wyolum/uControl_v3/KiCAD/BoM_uControl_v3.pdf

uControl_v3 | | | | Bill of Materials | | | www.wyolum.com
Reference | Quantity | Description | value | footprint | Manufacturer | Manufacturer PN | Distributor PN
BT1 | 1 | BATT_HOLDER | CR2032 | Keystone Electronics 3003 | 3003K-ND
BT2 | 1 | BATTERY LITHIUM COIN 3V 20MM BATT_COIN | -- | Panasonic - BSG | CR2032 | P189-ND
25 | CAP CER 0.1UF 100V 10% X7R 0805 100nF, 100V | 0805 (2012 Metric) | CL21B104KCC5PNC | 1276-2447-1-ND
C19,C33 | 2 | CAP CER 22UF 25V 10% X7R 1210 | 22uF X7R | 1210 (3225 Metric) | CL32B226KAJNNNE | 1276-3392-2-ND
C2,C3 | 2 | CAP CER 22PF 50V 5% NP0 0603 | 22pF, 50V | 0603 (1608 Metric) | CL10C220JB8NNNC | 1276-1023-1-ND
C21,C35 | 2 | CAP CER 3300PF 50V 10% X7R 0805 3.3nF, 50V | 0805 (2012 Metric) | CL21B332KBANNNC | 1276-1260-1-ND
C22,C26,C27,C36,C37,C42 | 6 | CAP ALUM 100UF 35V 20% SMD | 100uF, 35V | | UWT1V101MCL1GS | 493-2203-1-ND
C30,C38 | 2 | CAP CER 10UF 35V 10% X7R 1206 | 10uF, 35V | 1206 (3216 Metric) | CL31B106KLHNNNE | 1276-3103-1-ND
D1,D3,D4,D9 | 4 | DIODE GEN PURPOSE 200V 1A SMA S1D-13-F | DO-214AC, SMA | S1D-13-F | S1D-FDICT-ND
D5 | 1 | | LED 5V0 | 2-SMD, J-Lead | LG M67K-H1J2-24-Z | 475-2730-1-ND
D6 | 1 | | LED 3V3 | 2-SMD, J-Lead | LG M67K-H1J2-24-Z | 475-2730-1-ND
D7 | 1 | | LED BLINK | 2-SMD, J-Lead | LG M67K-H1J2-24-Z | 475-2730-1-ND
D8 | 1 | | LED 12V | 2-SMD, J-Lead | LG M67K-H1J2-24-Z | 475-2730-1-ND
J1 | 1 | | 5V_EXT | | PRPC002SFAN-RC | S1211EC-02-ND
J2 | 1 | | 3V3_EXT | | PRPC002SFAN-RC | S1211EC-02-ND
J3 | 1 | CONN HEADER 4POS .100 STR TIN | FCI | 67997-404HLF | 609-3242-ND

Distributor
(Link)
HOLDER BATTERY COIN 20MM DIA THM

Digikey (http://www.digikey.com/scripts/DkSearch/dksus.dll?x=0&y=0&lang=en&KeyWords=3003K-ND&cur=USD)

Digikey (http://www.digikey.com/product-detail/en/CR2032/P189-ND/31939?cur=USD)

C1,C4,C5,C7,C8,C9,C10,C1
1,C12,C13,C14,C17,C18,C2
0,C23,C28,C29,C31,C32,C3
4,C39,C40,C41,C43,C44

Samsung Electro-Mechanics America,
Inc

Digikey (http://www.digikey.com/product-detail/en/CL21B104KCC5PNC/1276-2447-1-ND/3890533)

Samsung Electro-Mechanics America,
Inc

Digikey (http://www.digikey.com/product-detail/en/CL32B226KAJNNNE/1276-3392-1-ND/3891478)

Samsung Electro-Mechanics America,
Inc

Digikey (http://www.digikey.com/product-detail/en/CL10C220JB8NNNC/1276-1023-1-ND/3889109)

Samsung Electro-Mechanics America,
Inc

Digikey (http://www.digikey.com/product-detail/en/CL21B332KBANNNC/1276-1260-1-ND/3889346)

Radial, Can – SMD, 0.260" L x 0.260" W (6.60mm x
6.60mm)
Nichicon | Digikey (http://www.digikey.com/product-detail/en/UWT1V101MCL1GS/493-2203-1-ND/590178)

Samsung Electro-Mechanics America,
Inc

Digikey (http://www.digikey.com/product-detail/en/CL31B106KLHNNNE/1276-3103-1-ND/3891189)

Diodes Inc | Digikey (http://www.digikey.com/product-detail/en/S1D-13-F/S1D-FDICT-ND/815934)

LED MINI TOPLED GREEN 570NM SMD

OSRAM Opto
Semiconductors Inc

Digikey (http://www.digikey.com/product-detail/en/LG%20M67K-H1J2-24-Z/475-2730-1-ND/1938897)

LED MINI TOPLED GREEN 570NM SMD

OSRAM Opto
Semiconductors Inc

Digikey (http://www.digikey.com/product-detail/en/LG%20M67K-H1J2-24-Z/475-2730-1-ND/1938897)

LED MINI TOPLED GREEN 570NM SMD

OSRAM Opto
Semiconductors Inc

Digikey (http://www.digikey.com/product-detail/en/LG%20M67K-H1J2-24-Z/475-2730-1-ND/1938897)

LED MINI TOPLED GREEN 570NM SMD

OSRAM Opto
Semiconductors Inc

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

CONN HEADER .100" SNGL STR 2POS

Through hole, 0.100"
(2.54mm)

Sullins Connector
Solutions

Digikey (http://www.digikey.com/product-detail/en/PRPC002SFAN-RC/S1211EC-02-ND/2775372)

CONN HEADER .100" SNGL STR 2POS

Through hole, 0.100"
(2.54mm)

Sullins Connector
Solutions

Digikey (http://www.digikey.com/product-detail/en/PRPC002SFAN-RC/S1211EC-02-ND/2775372)

addr | Through hole, 0.100"
(2.54mm)

Digikey (http://www.digikey.com/product-detail/en/67997-404HLF/609-3242-ND/1878458)

Reference | Quantity | Description | value | footprint | Manufacturer | Manufacturer PN | Distributor | Distributor PN
| | | | | | | (Link)
L1,L2 | 2 | | 2.2uH | | | XFL4020-222MEB | | 994-XFL4020-222MEB
P11 | 1 | | | | | PREC003SAAN-RC | | S1012EC-03-ND
P13 | 1 | | PWR_IN | | | PRPC002SFAN-RC | | S1211EC-02-ND
P14 | 1 | | X_VALVE | 8mm Solenoid Valve | | X-1-05-S-F | | X-1-05-S-F
P15 | 1 | | | Surface Mount, Right Angle | | 5023520400 | | WM7171CT-ND
P16 | 1 | | FLOWMETER | custom | | SFM3000 | | SFM3000
P17 | 1 | Pump_P54E01R_02 | PUMP | custom | | P54E01R | | P54E01R
P18 | 1 | Pump Cable | Pump Cable | --
P21,P22 | 2 | | CONN_23X2 | | | PREC028DFAN-RC | | S2212EC-28-ND
P24 | 1 | | PWR_IN | | | PJ-002B | | CP-002B-ND
P31 | 1 | | | --
P34 | 1 | | | | | PREC003SAAN-RC | | S1012EC-03-ND
P38 | 1 | | X_Valve2 | 8mm Solenoid Valve | | X-1-05-S-F | | X-1-05-S-F
P4 | 1 | | Header_ISP | | | PREC003DAAN-RC | | S2012EC-03-ND
P5 | 1 | | Header_FTDI | | | PREC006SAAN-RC | | S1012EC-06-ND
P7 | 1 | | GAGE_PR | HCEM500GUH9P3 | | HCEM500GUH9P3 | | HCEM500GUH9P3
P8 | 1 | Amplified pressure sensor | ABSO_PR | HDIB002AUY8H5 | | HDIB002AUY8H5 | | HDIB002AUY8H5
P9,P10 | 2 | | C3SB | | | PREC004SAAN-RC | | S1012EC-04-ND
Q1,Q2,Q3,Q4 | 4 | TRANS NPN 45V 1A 2W SOT223 | BCP5416TA | SOT-223 | | BCP5416TA | | BCP5416TACT-ND
Q5 | 1 | MOSFET NCH 60V 310MA SOT323 2N7002KW | SOT-323 | 2N7002KW | 2N7002KWCT-ND
| 10 | RES 10K OHM 1/8W 5% 0805 | 10k | 0805 (2012 Metric) | | RMCF0805JT10K0 | | RMCF0805JT10K0CT-ND
R16,R17,R18,R23 | 4 | RES 4.75K OHM 1/8W 1% 0805 | 4k75 | 0805 (2012 Metric) | | RMCF0805FT4K75 | | RMCF0805FT4K75CT-ND
R19,R20 | 2 | RES 1.5K OHM 1/8W 5% 0805 | 1k5 | 0805 (2012 Metric) | | RMCF0805JT1K50 | | RMCF0805JT1K50CT-ND
R24,R25 | 2 | RES 220 OHM 1/8W 5% 0805 | 220 | 0805 (2012 Metric) | | RMCF0805JT220R | | RMCF0805JT220RCT-ND
Power Inductor 2.2 uH 20 % 8 A | 4.3 mm W x 4.3 mm L x 2.1
mm H
| Coilcraft | Mouser (http://in.mouser.com/ProductDetail/Coilcraft/XFL4020-222MEB/?qs=VJjuEbE9QBO2bwonVBK1EA==)

CONN HEADER .100" SNGL STR
3POS
VSel_Vlv | Through hole, 0.100"
(2.54mm)
| Sullins Connector Solutions | Digikey (http://www.digikey.com/product-detail/en/PREC003SAAN-RC/S1012EC-03-ND/2774851)

CONN HEADER .100" SNGL STR 2POS

Through hole, 0.100"
(2.54mm)
| Sullins Connector Solutions | Digikey (http://www.digikey.com/product-detail/en/PRPC002SFAN-RC/S1211EC-02-ND/2775372)

Miniature Pneumatic Solenoid Valve

| Parker Hannifin | Parker Hannifin (http://ph.parker.com/webapp/wcs/stores/servlet/Product2_10151_12051_12163_-1_14107_14097___ProductDisplay)

CONN HEADER 4POS 2MM R/A
SMD
Flow_Conn | Molex Inc | Digikey (http://www.digikey.com/product-detail/en/5023520400/WM7171CT-ND/3045198)

Low-Pressure-Drop Flow Meter SFM3000

| Sensiron | Sensiron (http://www.sensirion.com/en/products/mass-flow-meters-for-gases/mass-flow-meter-sfm3000/)
| Oken Seiko | Oken Seiko (http://www.okenseiko.com/ja/prod/rollingP/air/P54E01R.pdf)

CONN HEADER .100" DUAL STR 56POS

Through hole, 0.100"
(2.54mm)
| Sullins Connector Solutions | DigiKey (http://www.digikey.com/product-detail/en/PREC028DFAN-RC/S2212EC-28-ND/2774986)

CONN POWER JACK MALE 2.5MM CLSD

Through Hole, Right Angle, 2.5mm ID, 5.5mm OD

| CUI Inc | DigiKey (http://www.digikey.com/product-search/en?vendor=0&keywords=CP-002B-ND)

Flowmeter Cable
CONN HEADER .100" SNGL STR 3POS
VSel_Vlv2 | Through hole, 0.100"
(2.54mm)
| Sullins Connector Solutions | Digikey (http://www.digikey.com/product-detail/en/PREC003SAAN-RC/S1012EC-03-ND/2774851)

Miniature Pneumatic Solenoid Valve

| Parker Hannifin | Parker Hannifin (http://ph.parker.com/webapp/wcs/stores/servlet/Product2_10151_12051_12163_-1_14107_14097___ProductDisplay)

CONN HEADER .100" DUAL STR 6POS

Through hole, 0.100"
(2.54mm)
| Sullins Connector Solutions | Digikey (http://www.digikey.com/product-detail/en/PREC003DAAN-RC/S2012EC-03-ND/2774891)

CONN HEADER .100" SNGL STR 6POS

Through hole, 0.100"
(2.54mm)
| Sullins Connector Solutions | Digikey (http://www.digikey.com/product-search/en?vendor=0&keywords=PREC006SAAN-RC)

Miniature amplified pressure sensor

| SensorTechnics | SensorTechnics (http://www.sensortechnics.com/en/products/pressure-sensors-and-transmitters/amplified-pressure-sensors/hce/)
| SensorTechnics | SensorTechnics (http://www.sensortechnics.com/en/products/pressure-sensors-and-transmitters/amplified-pressure-sensors/hdi/)
CONN HEADER .100" SNGL STR 4POS

Through hole, 0.100"
(2.54mm)
| Sullins Connector Solutions | Digikey (http://www.digikey.com/product-search/en?vendor=0&keywords=PREC004SAAN-RC)
| Diodes Inc | Digikey (http://www.digikey.com/product-detail/en/BCP5416TA/BCP5416TACT-ND/2712056)
| Fairchild Semiconductor | Digikey (http://www.digikey.com/product-detail/en/2N7002KW/2N7002KWCT-ND/3907885)

R1,R2,R3,R4,R11,R15,R21,
R22,R26,R27
| Stackpole Electronics Inc | DigiKey (http://www.digikey.com/product-detail/en/RMCF0805JT10K0/RMCF0805JT10K0CT-ND/1942577)
| Stackpole Electronics Inc | DigiKey (http://www.digikey.com/product-detail/en/RMCF0805FT4K75/RMCF0805FT4K75CT-ND/1942413)
| Stackpole Electronics Inc | Digikey (http://www.digikey.com/product-detail/en/RMCF0805JT1K50/RMCF0805JT1K50CT-ND/1942560)
| Stackpole Electronics Inc | Digikey (http://www.digikey.com/product-detail/en/RMCF0805JT220R/RMCF0805JT220RCT-ND/1942544)

Reference | Quantity | Description | value | footprint | Manufacturer | Manufacturer PN | Distributor | Distributor PN
| | | | | | | (Link)
R5,R12 | 2 | RES 4.7K OHM 1/8W 5% 0805 | 4k7 | 0805 (2012 Metric) | | RMCF0805JT4K70 | | RMCF0805JT4K70CT-ND
R6,R10,R13 | 3 | RES 1K OHM 1/8W 5% 0805 | 1k | 0805 (2012 Metric) | | RMCF0805JT1K00 | | RMCF0805JT1K00CT-ND
R7,R14 | 2 | RES 100K OHM 1/8W 5% 0805 | 100k | 0805 (2012 Metric) | | RMCF0805JT100K | | RMCF0805JT100KCT-ND
R8 | 1 | RES 330 OHM 1/8W 5% 0805 | 330 | 0805 (2012 Metric) | | RMCF0805JT330R | | RMCF0805JT330RCT-ND
R9 | 1 | RES 120 OHM 1/8W 5% 0805 | 120 | 0805 (2012 Metric) | | RMCF0805JT120R | | RMCF0805JT120RCT-ND
SP1 | 1 | | BUZZER | | TDK Corporation | PS1240P02BT | | 445-2525-1-ND
SW1 | 1 | Reset | Through Hole, Right Angle TE Connectivity | FSMRA3JH | 450-1657-ND
SW2 | 1 | INT0 | Through Hole, Right Angle TE Connectivity | FSMRA3JH | 450-1657-ND
SW3 | 1 | INT1 | Through Hole, Right Angle TE Connectivity | FSMRA3JH | 450-1657-ND
SW4 | 1 | PWR_BBB | Through Hole, Right Angle TE Connectivity | FSMRA3JH | 450-1657-ND
SW5 | 1 | GPIO1_6 | Through Hole, Right Angle TE Connectivity | FSMRA3JH | 450-1657-ND
SW6 | 1 | GPIO1_29 | Through Hole, Right Angle TE Connectivity | FSMRA3JH | 450-1657-ND
U1 | 1 | TXB0104D | Texas Instruments TXB0104DR | 296-21928-1-ND
U10 | 1 | BEAGLEBONEBLACK | BEAGLEBONEBLACK custom
U11 | 1 | IC ACCEL SPI/I2C 3AX 14LGA | ADXL345B | 14-VFLGA | | ADXL345BCCZ-RL7 | | ADXL345BCCZ-RL7CT-ND
U3 | 1 | IC REG BUCK SYNC 5V 3A 16QFN | TPS62133RGTT | 16-VFQFN Exposed Pad | Texas Instruments TPS62133RGTT | 296-30225-1-ND
U4 | 1 | IC REG BUCK SYNC 3.3V 3A 16QFN TPS62132RGTT | 16-VFQFN Exposed Pad | Texas Instruments TPS62132RGTT | 296-30224-1-ND
U5 | 1 | IC RTC W/TCXO 16-SOIC | DS3231S# | | Maxim Integrated | DS3231S# | | DS3231S#-ND
U7 | 1 | IC MCU 8BIT 32KB FLASH 32TQFP ATMEGA328-AU | 32-TQFP | ATMEGA328-AU | ATMEGA328-AU-ND
U8 | 1 | TXS0108EPWR | Texas Instruments TXS0108EPWR | 296-23011-1-ND
U9 | 1 | IC EEPROM 256KBIT 400KHZ 8SOIC CAT24C256 | ON Semiconductor CAT24C256WI-GT3
X1 | 1 | CRYSTAL 16MHZ 9PF SMD | 16MHz | 4-SMD, No Lead (DFN, LCC) EPSON | SER3628CT-ND
M1 | 1 | Distribution block for air path | MANIFOLD | Manifold2 | | -- | -- | --

Stackpole
Electronics Inc

DigiKey (http://www.digikey.com/product-detail/en/RMCF0805JT4K70/RMCF0805JT4K70CT-ND/1942570)

Stackpole
Electronics Inc

DigiKey (http://www.digikey.com/product-detail/en/RMCF0805JT1K00/RMCF0805JT1K00CT-ND/1942557)

Stackpole
Electronics Inc

DigiKey (http://www.digikey.com/product-detail/en/RMCF0805JT100K/RMCF0805JT100KCT-ND/1942592)

Stackpole
Electronics Inc

Digikey (http://www.digikey.com/product-detail/en/RMCF0805JT330R/RMCF0805JT330RCT-ND/1942547)

Stackpole
Electronics Inc

DigiKey (http://www.digikey.com/product-detail/en/RMCF0805JT120R/RMCF0805JT120RCT-ND/1942540)

BUZZER PIEZO 4KHZ 12.2MM PC MNT

Circular - 12.20mm Dia x
6.50mm H, 5mm pitch

DigiKey (http://www.digikey.com/product-detail/en/PS1240P02BT/445-2525-1-ND/935930)

SWITCH TACTILE SPST-NO 0.05A 12V

DigiKey (http://www.digikey.com/product-detail/en/FSMRA3JH/450-1657-ND/1632543?cur=USD)

SWITCH TACTILE SPST-NO 0.05A 12V

DigiKey (http://www.digikey.com/product-detail/en/FSMRA3JH/450-1657-ND/1632543?cur=USD)

SWITCH TACTILE SPST-NO 0.05A 12V

DigiKey (http://www.digikey.com/product-detail/en/FSMRA3JH/450-1657-ND/1632543?cur=USD)

SWITCH TACTILE SPST-NO 0.05A 12V

DigiKey (http://www.digikey.com/product-detail/en/FSMRA3JH/450-1657-ND/1632543?cur=USD)

SWITCH TACTILE SPST-NO 0.05A 12V

DigiKey (http://www.digikey.com/product-detail/en/FSMRA3JH/450-1657-ND/1632543?cur=USD)

SWITCH TACTILE SPST-NO 0.05A 12V

DigiKey (http://www.digikey.com/product-detail/en/FSMRA3JH/450-1657-ND/1632543?cur=USD)

IC VOLT-LEVEL TRANSLATOR 14-SOIC

14-SOIC (0.154", 3.90mm
Width)

DigiKey (http://www.digikey.com/product-detail/en/TXB0104DR/296-21928-1-ND/1629281)

Beagleboard.org | Beagleboard.org (http://beagleboard.org/Products/BeagleBone%20Black)
Analog Devices Inc | DigiKey (http://www.digikey.com/product-detail/en/ADXL345BCCZ-RL7/ADXL345BCCZ-RL7CT-ND/2038984)
DigiKey (http://www.digikey.com/product-detail/en/TPS62133RGTT/296-30225-1-ND/2982139)
DigiKey (http://www.digikey.com/product-detail/en/TPS62132RGTT/296-30224-1-ND/2982137)

16-SOIC (0.295", 7.50mm
Width)

DigiKey (http://www.digikey.com/product-detail/en/DS3231S#/DS3231S%23-ND/1197574)

Atmel | DigiKey (http://www.digikey.com/product-detail/en/ATMEGA328-AU/ATMEGA328-AU-ND/2271029)
IC 8BIT NON-INV TRANSLTR
20TSSOP

20-TSSOP (0.173", 4.40mm
Width)

DigiKey (http://www.digikey.com/product-detail/en/TXS0108EPWR/296-23011-1-ND/1775304)

8-SOIC (0.154", 3.90mm
Width)
DigiKey (http://www.digikey.com/product-detail/en/CAT24C256WI-GT3/CAT24C256WI-GT3OSCT-ND/2704982) | CAT24C256WI-GT3OSCT-
ND
TSX-3225
16.0000MF09Z-AC3

DigiKey (http://www.digikey.com/product-detail/en/TSX-3225%2016.0000MF09Z-AC3/SER3628CT-ND/1802879)

Wyolum
