wyolum/uControl_v3/KiCAD/scad/uControl_v3_keepout.pdf

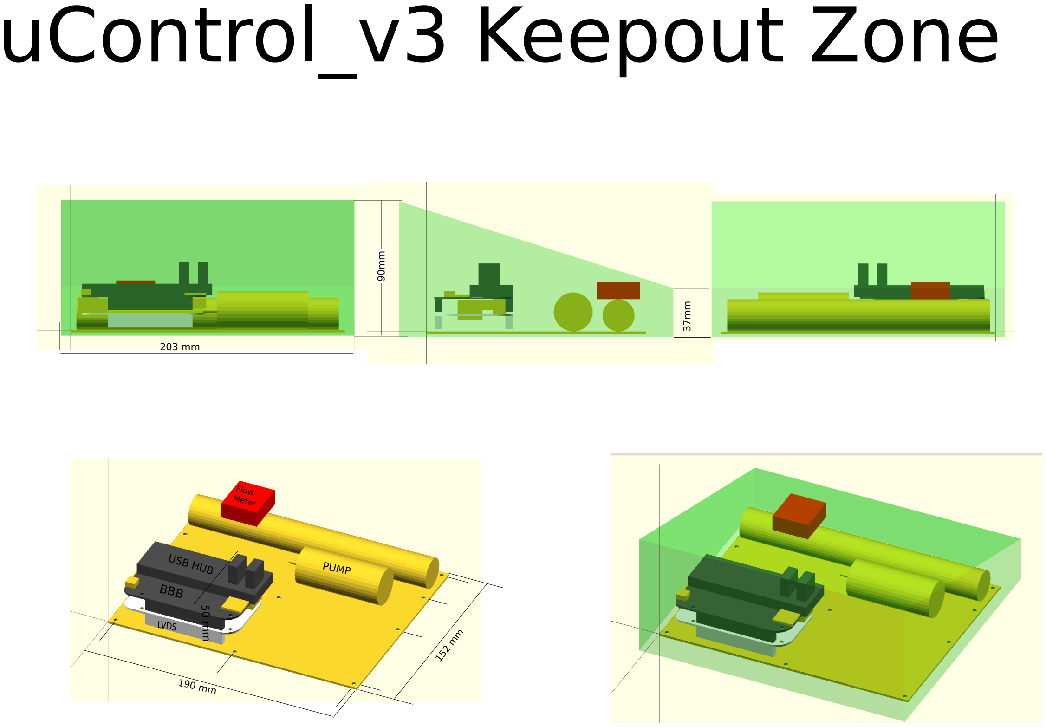
[picture p1: page 1]

190 mm

152 mm

50 mm
LVDS

BBB

USB HUB

Flow
Meter

PUMP

90mm

37mm

203 mm

uControl_v3 Keepout Zone
