wyolum/uControl_v3/KiCAD/uControl_v3_Images/uControl_v3_01.png

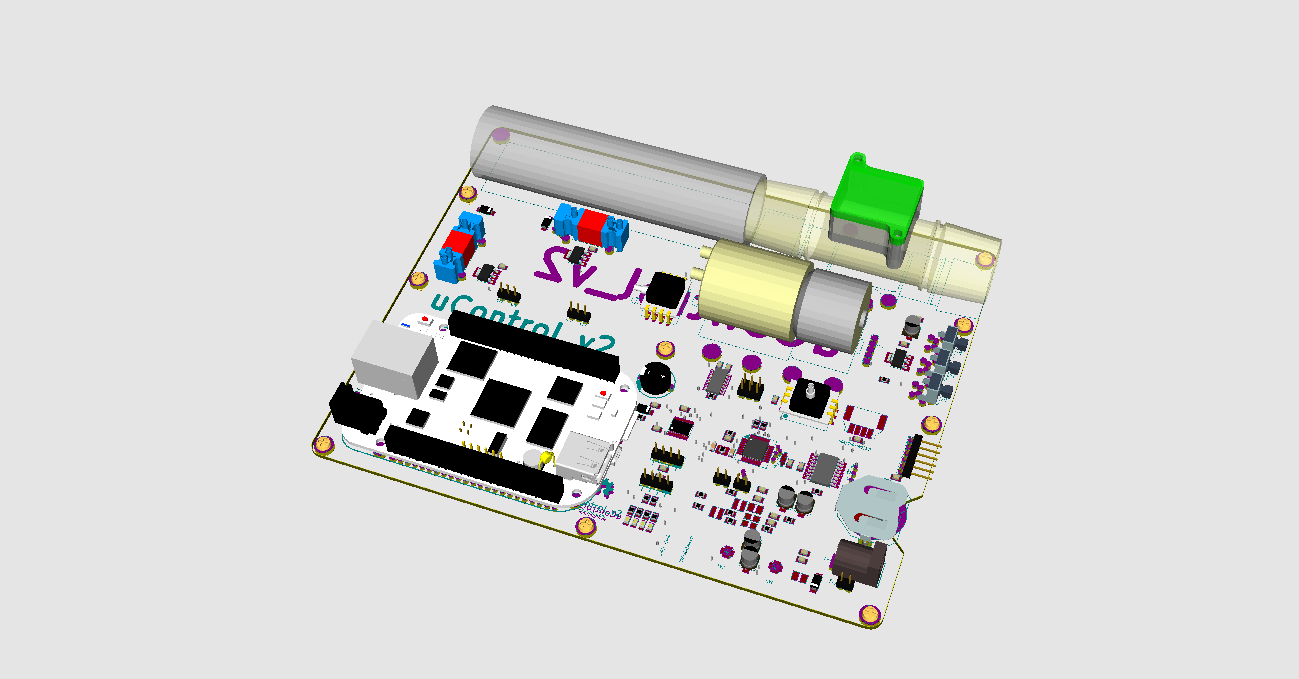
KiCAD/uControl_v3_Images/uControl_v3_01.png
