wyolum/uControl_v3/KiCAD/uControl_v3_Images/uControl_v3_03.png

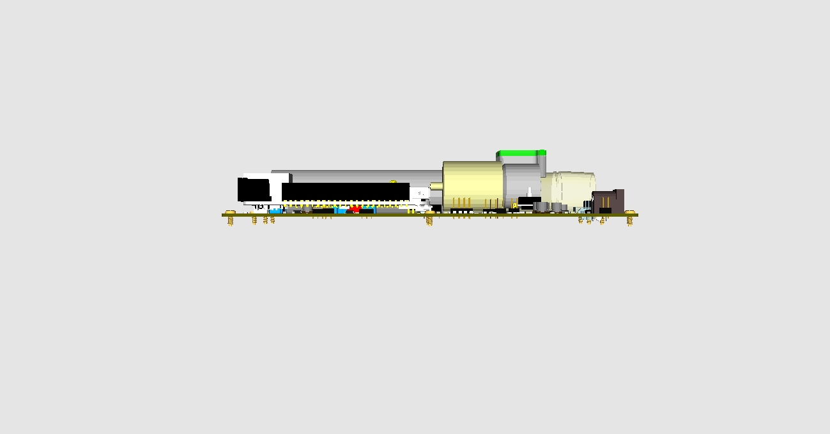
KiCAD/uControl_v3_Images/uControl_v3_03.png
