wyolum/uControl_v3/fabricate/plunger_holder.stl

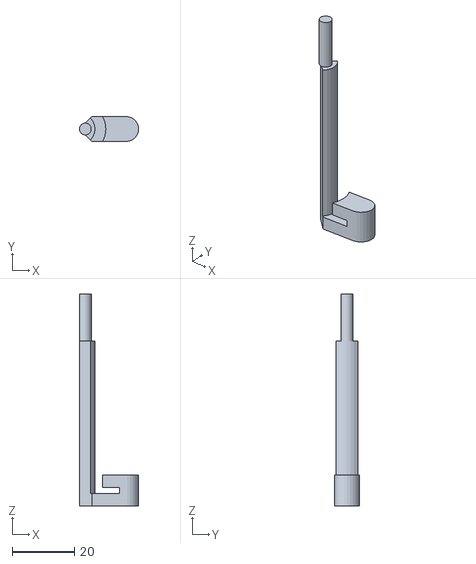
[picture p5: CAD file, 2015-09-16]
fabricate/plunger_holder.stl
19.0 x 8.00 x 68.0
