wyolum/uControl_v3/KiCAD/uControl_v3_3Dpcb.obj

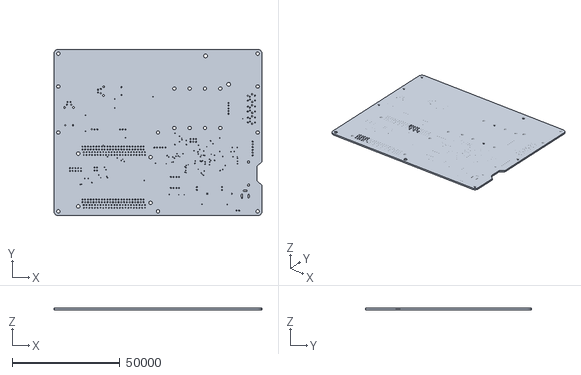
[picture p6: CAD file, 2015-07-04]
KiCAD/uControl_v3_3Dpcb.obj
96520.0 x 77216.0 x 812.8
