wyolum/uControl_v3/(list of files, cad)

Other CAD files:
fabricate/spring_catch.scad
KiCAD/scad/uControl_v3_keepout.scad
KiCAD/scad/BBB.scad
KiCAD/scad/flow_meter.scad
KiCAD/scad/manifold_parts.scad
