wyolum/uControl_v3/KiCAD/uC_v3_sch.pdf

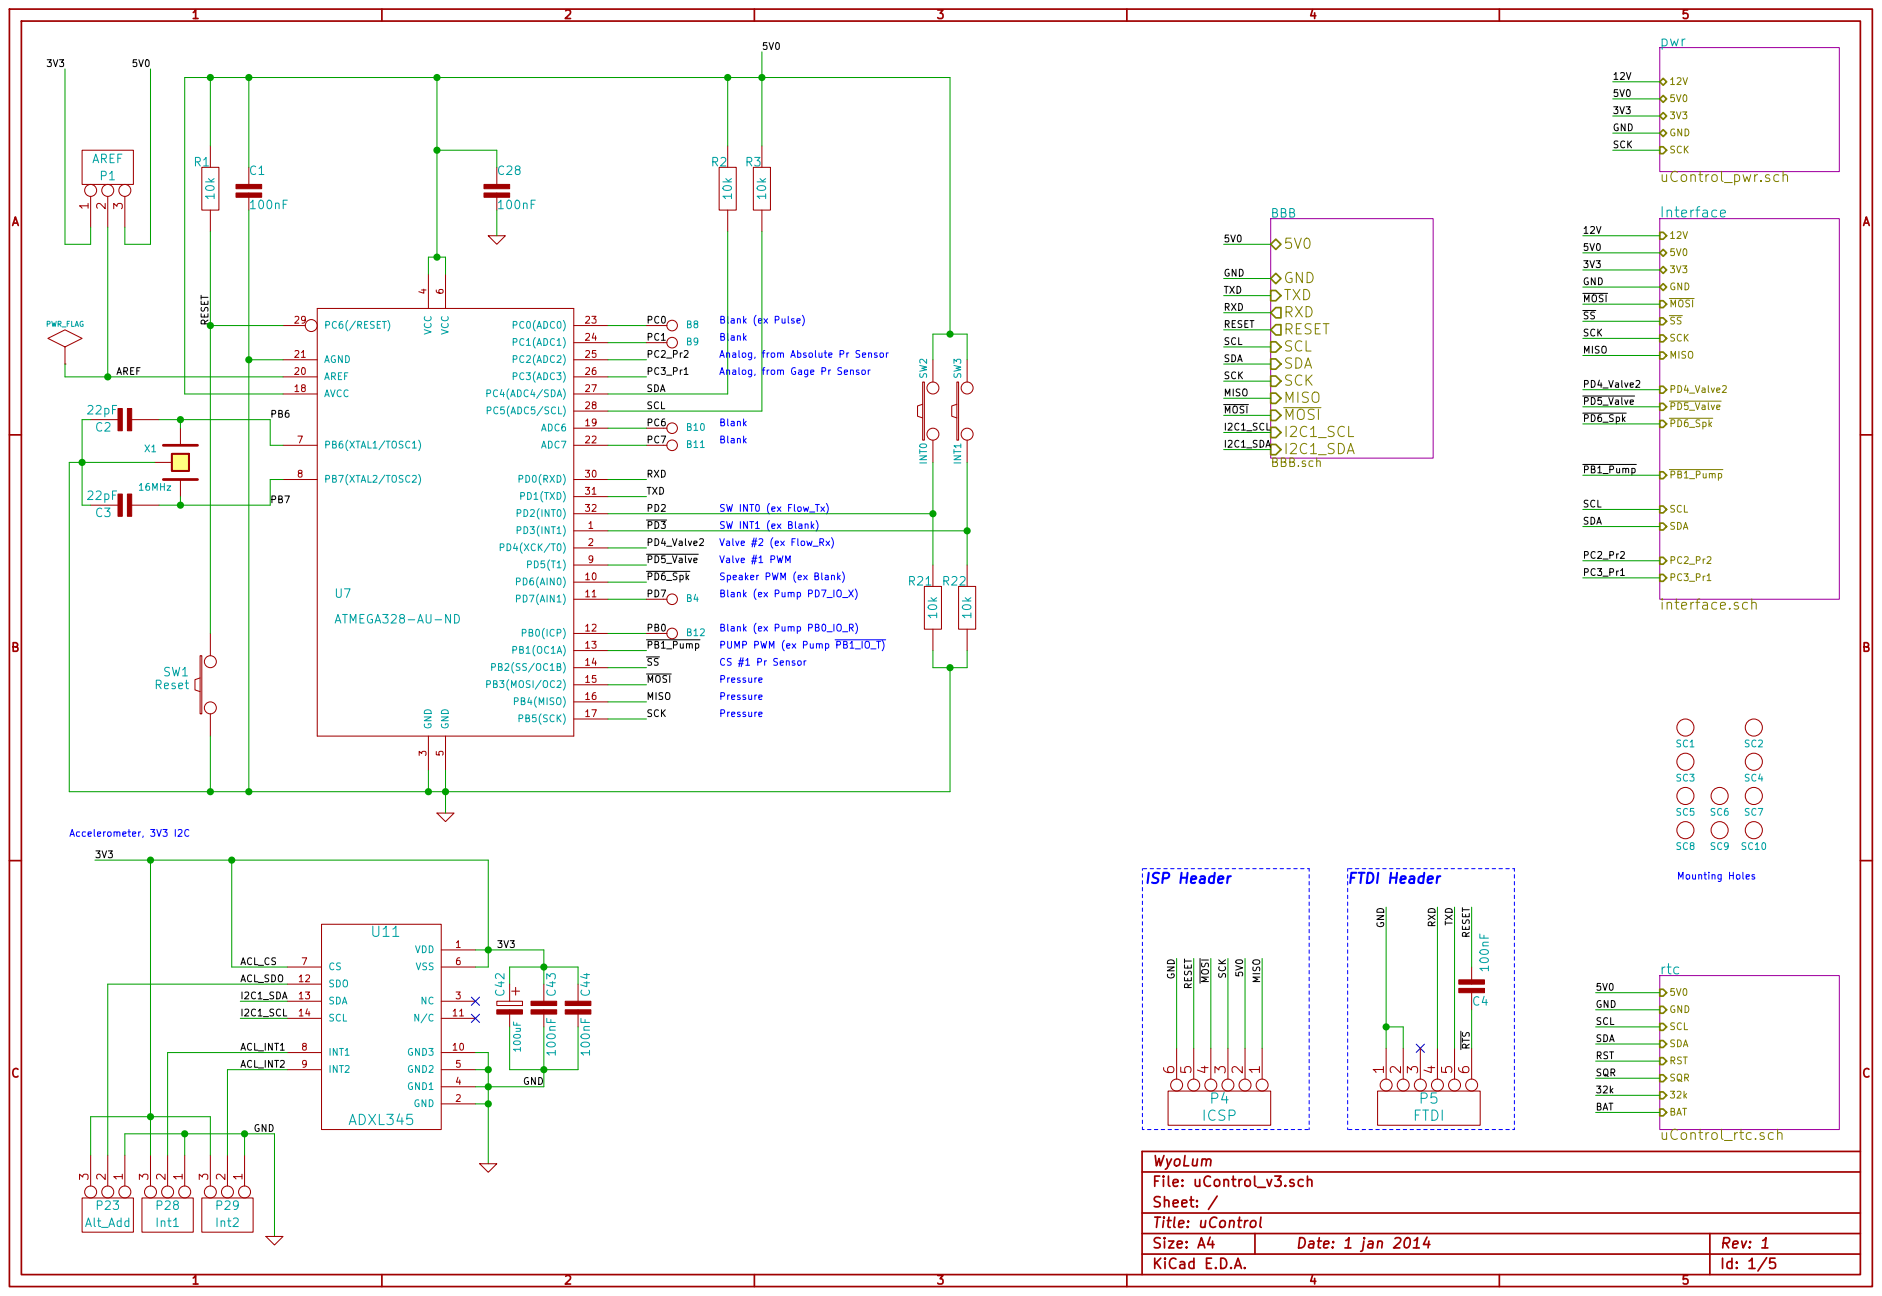
[picture p7: page 1]

3V3 Pressure Pressure Pressure CS #1 Pr Sensor PUMP PWM (ex Pump PB1_IO_T) Blank (ex Pump PB0_IO_R) Blank (ex Pump PD7_IO_X) Speaker PWM (ex Blank) Valve #1 PWM

SCL SSMOSI SCK MISO

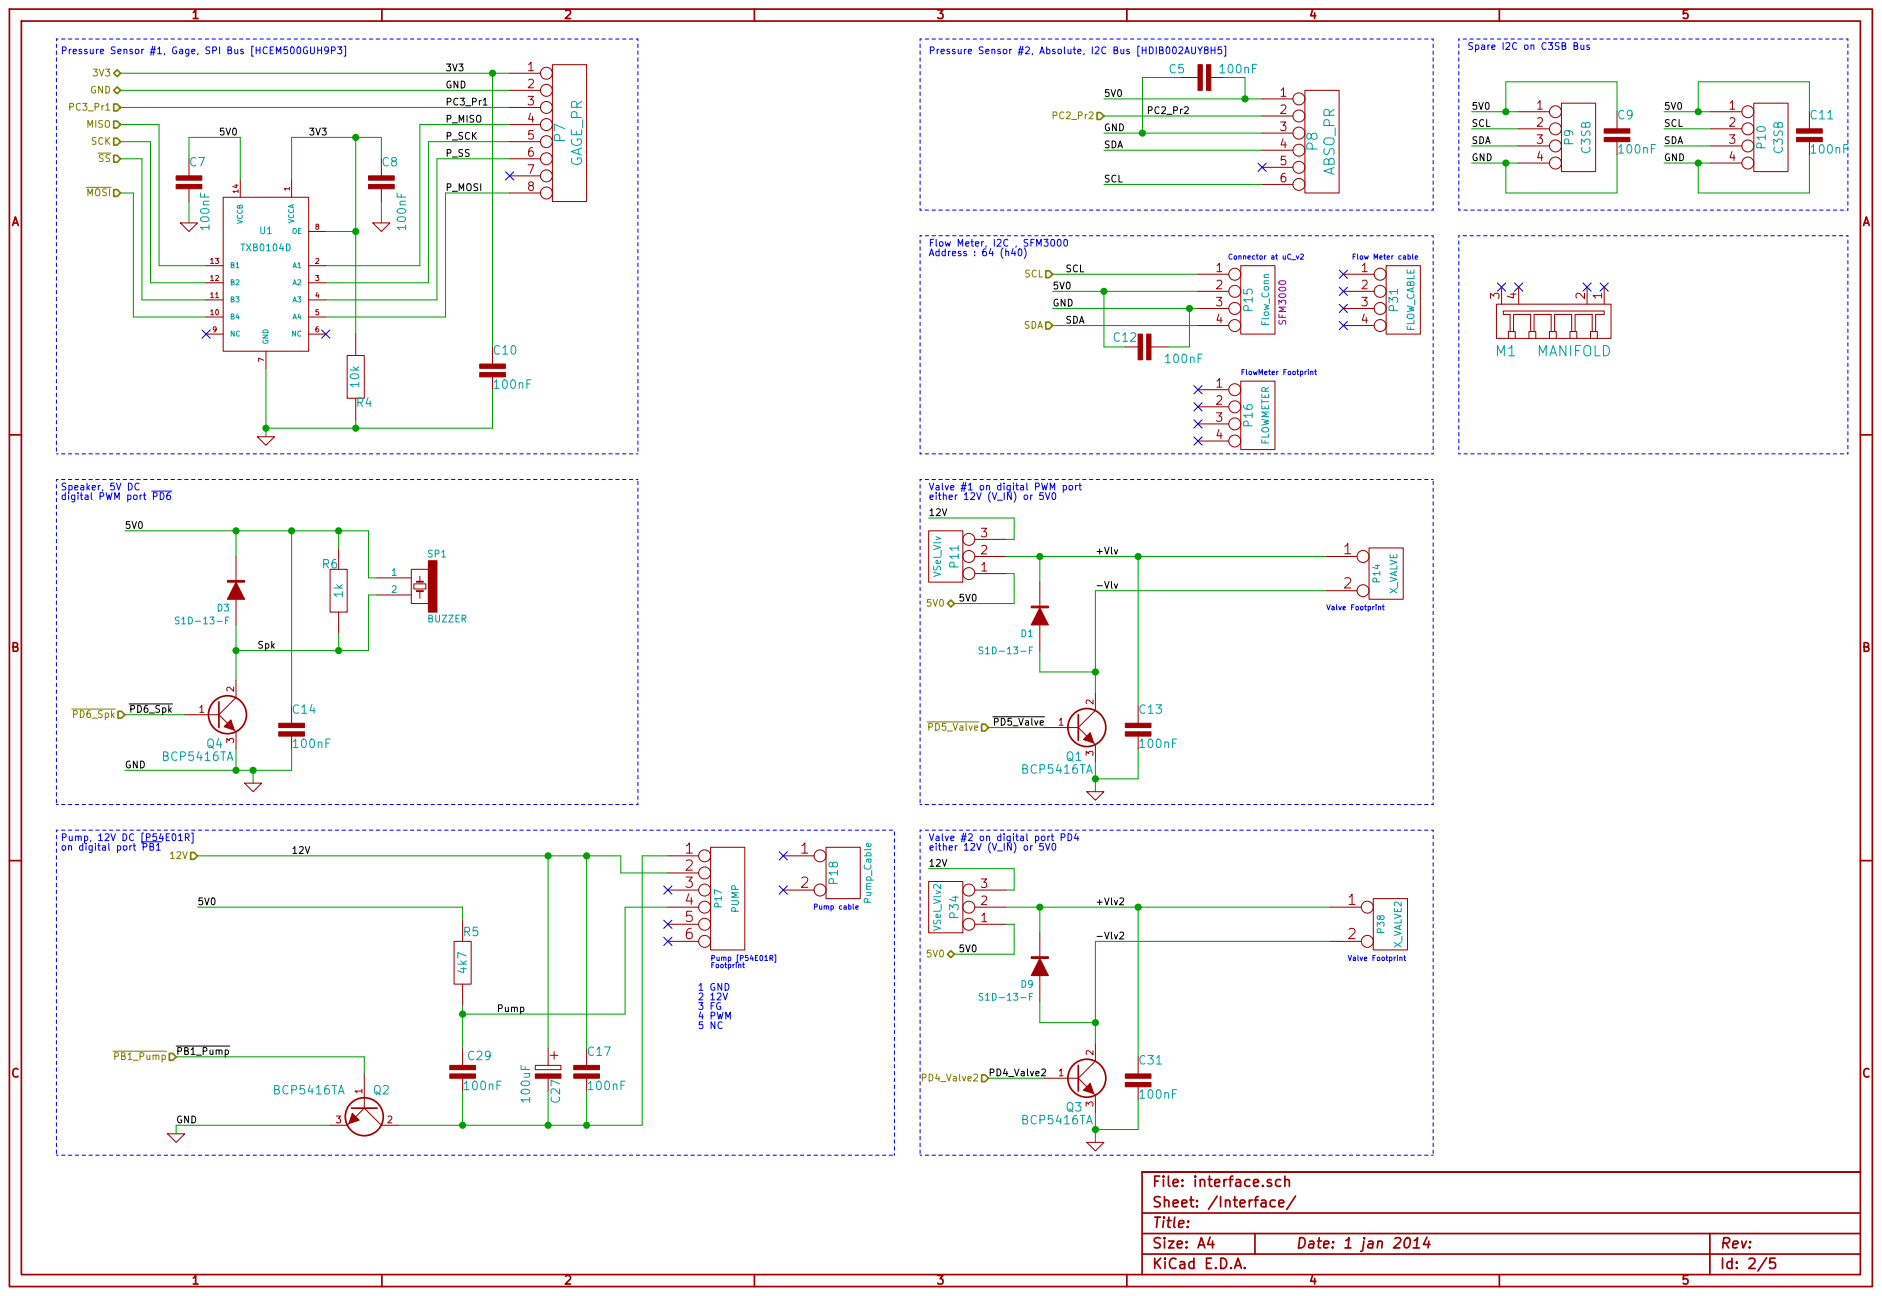
[picture p8: page 2]

PC2_Pr2 SCL Pressure Sensor #2, Absolute, I2C Bus [HDIB002AUY8H5] PC2_Pr2

SCL SDA MOSI SS

Speaker, 5V DC
digital PWM port PD6 GND

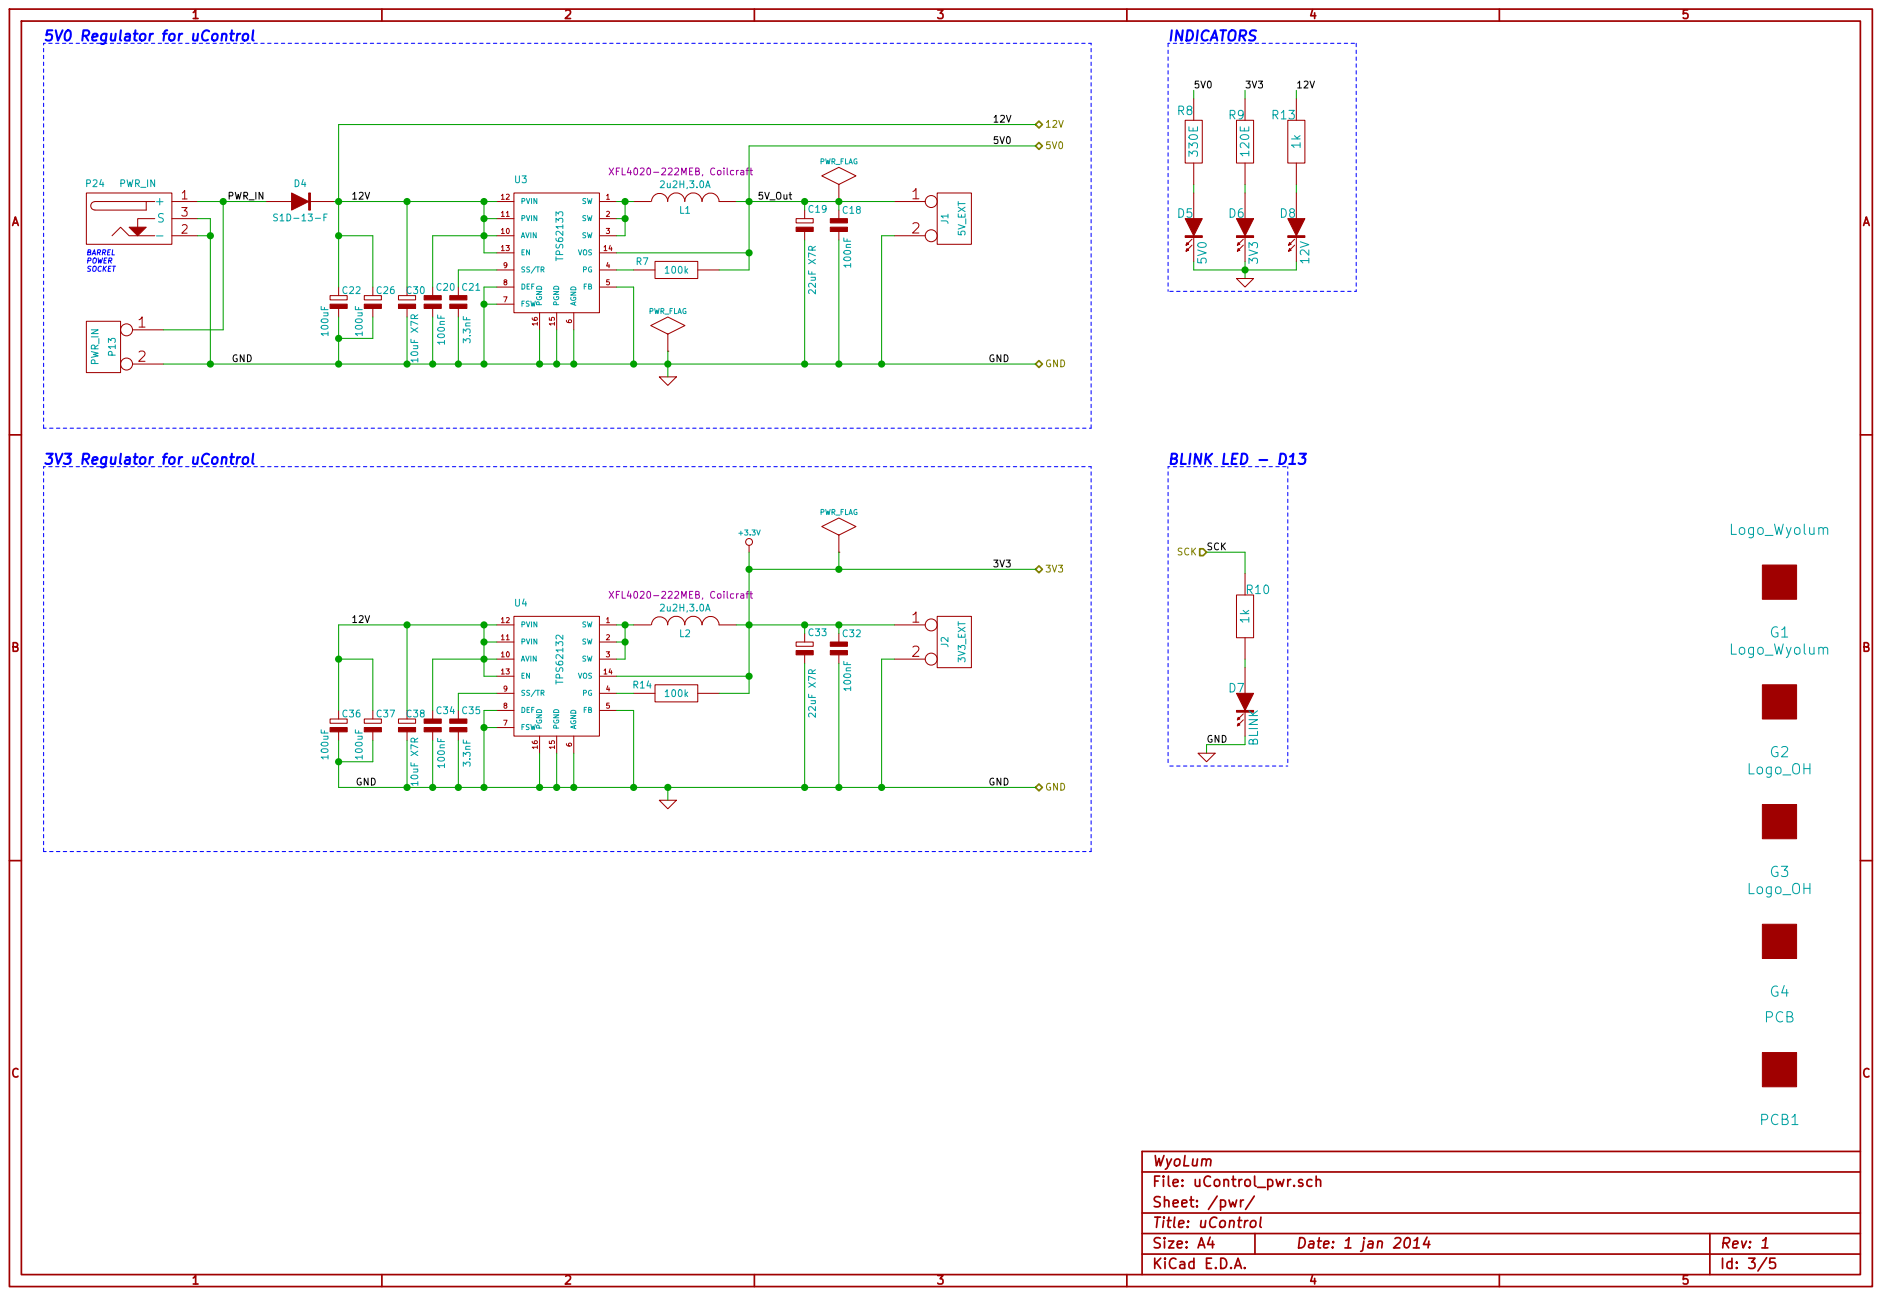
[picture p9: page 3]

6 FSW 7 DEF 8 SS/TR 9 AVIN 10 PVIN 11 PVIN 12 EN 13 VOS 14 PGND 15 PGND 16 U3 TPS62133 C20100nF C213.3nF

6 FSW 7 DEF 8 SS/TR 9 AVIN 10 PVIN 11 PVIN 12 EN 13 VOS 14 PGND 15 PGND 16 U4 TPS62132 C34100nF C353.3nF

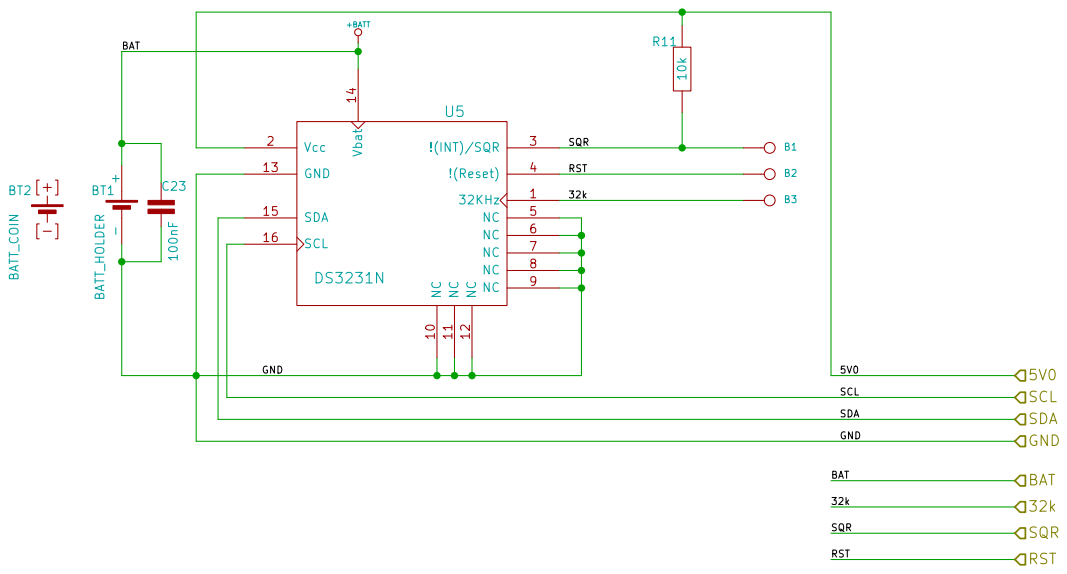
[picture p10: page 4]

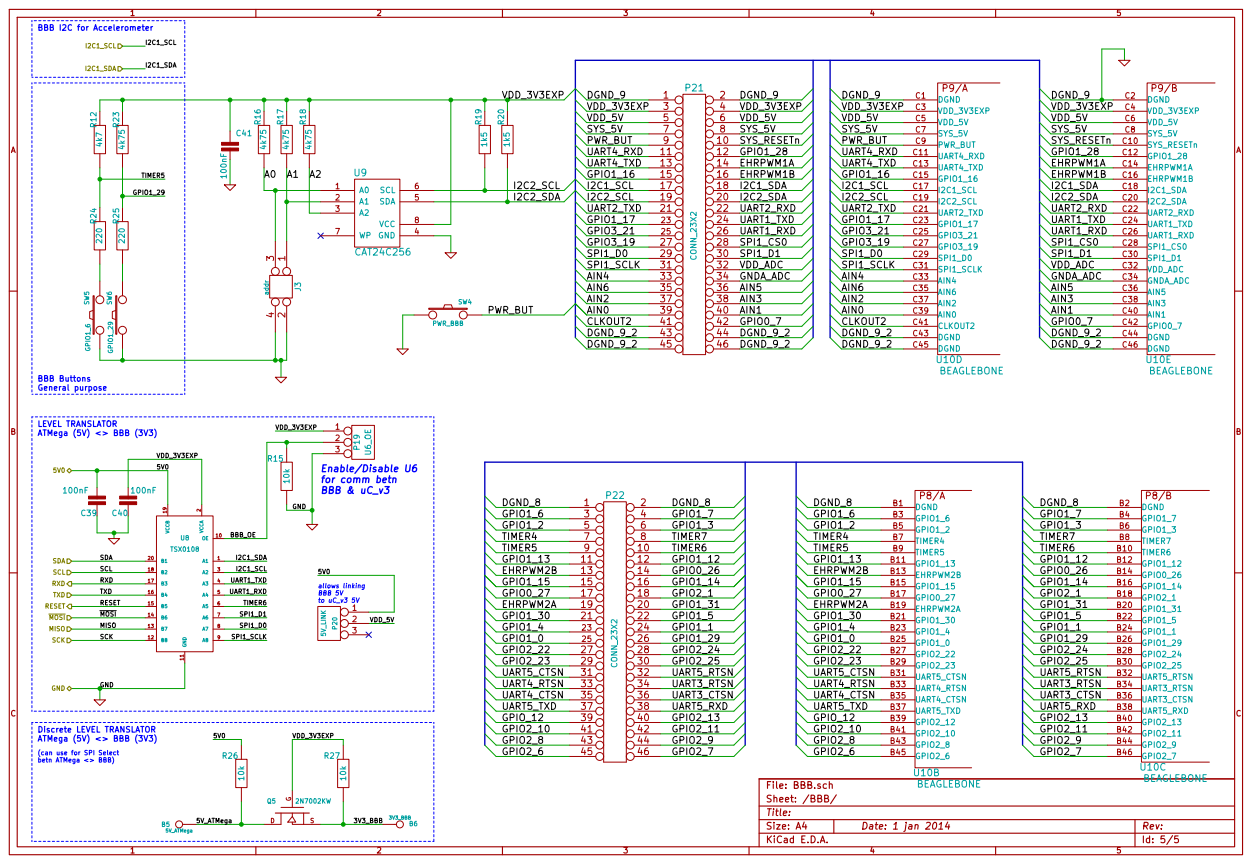
[picture p11: page 5]

(can use for SPI Select betn ATMega <> BBB) BBB Buttons General purpose BBB I2C for Accelerometer

LEVEL TRANSLATOR
ATMega (5V) <> BBB (3V3) Discrete LEVEL TRANSLATOR

5V0Enable/Disable U6
for comm betn BBB & uC_v3

allows linking BBB 5V to uC_v3 5V

Id: 5/5 Title: File: BBB.sch Sheet: /BBB/
