wyolum/uControl_v3/KiCAD/uControl_v3.kicad_pcb

## KiCad design KiCAD/uControl_v3.kicad_pcb (2015-07-04)

Schematic: uControl_v3.sch, uControl

Parts:
B4, B12: PB0; I_O
B8: PC0; I_O
B9: PC1; I_O
B10: PC6; I_O
B11: PC7; I_O
C1, C4, C28, C43, C44: 100nF; c_0805
C2, C3: 22pF; c_0603
C42: 100uF; C_ELCO_SMD
P1: AREF; ShortLink2
P4: ICSP; Header_ISP
P5: FTDI; Header_FTDI
P23: Alt_Add; ShortLink2
P28: Int1; ShortLink2
P29: Int2; ShortLink2
R1, R2, R3, R21, R22: 10k; r_0805
SC1, SC2, SC3, SC4, SC5, SC6, SC7, SC8, SC9, SC10: SCREW; vite_3mm
SW1: Reset; SW_PB_V_H
SW2: INT0; SW_PB_V_H
SW3: INT1; SW_PB_V_H
U7: ATMEGA328-AU-ND; TQFP32
U11: ADXL345
X1: 16MHz; Xtal_SMD3

Connections:
+3.3V: C42.1 (+), C43.1, C44.1, P1.1, P23.3, P28.3, P29.3, U11.1 (VDD), U11.6 (VSS), U11.7 (CS); also elsewhere on the board
/ACL_INT1: P28.2, U11.8 (INT1)
/ACL_INT2: P29.2, U11.9 (INT2)
/ACL_SDO: P23.2, U11.12 (SDO)
/AREF: P1.2, U7.20 (AREF)
/BBB/5V0: C1.1, C28.1, P1.3, P4.2, R1.1, R2.1, R3.1, SW2.2, SW3.2, U7.4 (VCC), U7.6 (VCC), U7.18 (AVCC); also elsewhere on the board
/BBB/I2C1_SCL: U11.14 (SCL); also elsewhere on the board
/BBB/I2C1_SDA: U11.13 (SDA); also elsewhere on the board
/BBB/MISO: P4.1, U7.16 (PB4(MISO)); also elsewhere on the board
/BBB/RESET: C4.2, P4.5, R1.2, SW1.2, U7.29 (PC6(/RESET)); also elsewhere on the board
/BBB/RXD: P5.4, U7.30 (PD0(RXD)); also elsewhere on the board
/BBB/SCK: P4.3, U7.17 (PB5(SCK)); also elsewhere on the board
/BBB/SCL: R3.2, U7.28 (PC5(ADC5/SCL)); also elsewhere on the board
/BBB/SDA: R2.2, U7.27 (PC4(ADC4/SDA)); also elsewhere on the board
/BBB/TXD: P5.5, U7.31 (PD1(TXD)); also elsewhere on the board
/BBB/~MOSI: P4.4, U7.15 (PB3(MOSI/OC2)); also elsewhere on the board
/Interface/PC2_Pr2: U7.25 (PC2(ADC2)); also elsewhere on the board
/Interface/PC3_Pr1: U7.26 (PC3(ADC3)); also elsewhere on the board
/Interface/PD4_Valve2: U7.2 (PD4(XCK/T0)); also elsewhere on the board
/Interface/~PB1_Pump: U7.13 (PB1(OC1A)); also elsewhere on the board
/Interface/~PD5_Valve: U7.9 (PD5(T1)); also elsewhere on the board
/Interface/~PD6_Spk: U7.10 (PD6(AIN0)); also elsewhere on the board
/Interface/~SS: U7.14 (PB2(SS/OC1B)); also elsewhere on the board
/PB0: B12.1, U7.12 (PB0(ICP))
/PB6: C2.1, U7.7 (PB6(XTAL1/TOSC1)), X1.1
/PB7: C3.1, U7.8 (PB7(XTAL2/TOSC2)), X1.2
/PC0: B8.1, U7.23 (PC0(ADC0))
/PC1: B9.1, U7.24 (PC1(ADC1))
/PC6: B10.1, U7.19 (ADC6)
/PC7: B11.1, U7.22 (ADC7)
/PD2: R21.1, SW2.1, U7.32 (PD2(INT0))
/PD7: B4.1, U7.11 (PD7(AIN1))
/~PD3: R22.1, SW3.1, U7.1 (PD3(INT1))
/~RTS: C4.1, P5.6
GND: C1.2, C2.2, C3.2, C28.2, C42.2 (-), C43.2, C44.2, P4.6, P5.1, P5.2, P23.1, P28.1, P29.1, R21.2, R22.2, SW1.1, U7.3 (GND), U7.5 (GND), U7.21 (AGND), U11.2 (GND), U11.4 (GND1), U11.5 (GND2), U11.10 (GND3), X1.3; also elsewhere on the board

Notes on the sheet:
SW INT1 (ex Blank)
Mounting Holes
Pressure
CS #1 Pr Sensor
PUMP PWM (ex Pump ~PB1_IO_T)
Blank (ex Pump PB0_IO_R)
Blank (ex Pump PD7_IO_X)
Speaker PWM (ex Blank)
Valve #1 PWM
Valve #2 (ex Flow_Rx)
SW INT0 (ex Flow_Tx)
FTDI Header
ISP Header
Blank (ex Pulse)
Blank
Analog, from Absolute Pr Sensor
Analog, from Gage Pr Sensor
Accelerometer, 3V3 I2C

Schematic: interface.sch

Parts:
C5, C7, C8, C9, C10, C11, C12, C13, C14, C17, C29, C31: 100nF; c_0805
C27: 100uF; C_ELCO_SMD
D1, D3, D9: S1D-13-F; diode-DO214AC
M1: MANIFOLD
P7: GAGE_PR; HCEM500GUH9P3
P8: ABSO_PR; HDIB002AUY8H5
P9, P10: C3SB; pin_strip_4-90
P11: VSel_Vlv; Header_3
P14: X_VALVE; X_Valve_2
P15: Flow_Conn; Conn_Flow_SFM3000_Male
P16: FLOWMETER; FlowMeter_SFM3000
P17: PUMP; Pump_P54E01R_02
P18: Pump_Cable
P31: FLOW_CABLE
P34: VSel_Vlv2; Header_3
P38: X_VALVE2; X_Valve_2
Q1, Q2, Q3, Q4: BCP5416TA; SOT223
R4: 10k; r_0805
R5: 4k7; r_0805
R6: 1k; r_0805
SP1: BUZZER; Speaker
U1: TXB0104D

Connections:
+3.3V: C8.1, C10.1, P7.1, R4.2, U1.1 (VCCA), U1.8 (OE); also elsewhere on the board
/BBB/5V0: C5.2, C7.1, C9.1, C11.1, C12.2, C14.1, D3.2 (K), P8.1, P9.1, P10.1, P11.1, P15.2, P34.1, R5.1, R6.1, SP1.1, U1.14 (VCCB); also elsewhere on the board
/BBB/MISO: U1.13 (B1); also elsewhere on the board
/BBB/SCK: U1.12 (B2); also elsewhere on the board
/BBB/SCL: P8.6, P9.2, P10.2, P15.1; also elsewhere on the board
/BBB/SDA: P8.4, P9.3, P10.3, P15.4; also elsewhere on the board
/BBB/~MOSI: U1.10 (B4); also elsewhere on the board
/Interface/12V: C17.1, C27.1 (+), P11.3, P17.2, P34.3; also elsewhere on the board
/Interface/+Vlv: C13.1, D1.2 (K), P11.2, P14.1
/Interface/+Vlv2: C31.1, D9.2 (K), P34.2, P38.1
/Interface/-Vlv: D1.1 (A), P14.2 (PM), Q1.2 (C)
/Interface/-Vlv2: D9.1 (A), P38.2 (PM), Q3.2 (C)
/Interface/PC2_Pr2: P8.2; also elsewhere on the board
/Interface/PC3_Pr1: P7.3; also elsewhere on the board
/Interface/PD4_Valve2: Q3.1 (B); also elsewhere on the board
/Interface/P_MISO: P7.4, U1.2 (A1)
/Interface/P_MOSI: P7.8, U1.5 (A4)
/Interface/P_SCK: P7.5, U1.3 (A2)
/Interface/P_SS: P7.6, U1.4 (A3)
/Interface/Pump: C29.1, P17.4, R5.2
/Interface/Spk: D3.1 (A), Q4.2 (C), R6.2, SP1.2
/Interface/~PB1_Pump: Q2.1 (B); also elsewhere on the board
/Interface/~PD5_Valve: Q1.1 (B); also elsewhere on the board
/Interface/~PD6_Spk: Q4.1 (B); also elsewhere on the board
/Interface/~SS: U1.11 (B3); also elsewhere on the board
GND: C5.1, C7.2, C8.2, C9.2, C10.2, C11.2, C12.1, C13.2, C14.2, C31.2, P7.2, P8.3, P9.4, P10.4, P15.3, Q1.3 (E), Q2.3 (E), Q3.3 (E), Q4.3 (E), R4.1, U1.7 (GND); also elsewhere on the board
unnamed: C17.2, C27.2 (-), C29.2, P17.1, Q2.2 (C)

Notes on the sheet:
Flow Meter cable
Spare I2C on C3SB Bus
Pressure Sensor #2, Absolute, I2C Bus [HDIB002AUY8H5]
Valve #1 on digital PWM port either 12V (V_IN) or 5V0
Flow Meter, I2C , SFM3000 Address : 64 (h40)
Pressure Sensor #1, Gage, SPI Bus [HCEM500GUH9P3]
Pump, 12V DC [P54E01R] on digital port ~PB1
FlowMeter Footprint
Connector at uC_v2
Pump [P54E01R] Footprint
Pump cable
Valve #2 on digital port PD4 either 12V (V_IN) or 5V0
Speaker, 5V DC digital PWM port ~PD6
Valve Footprint
1 GND 2 12V 3 FG 4 PWM 5 NC

Schematic: uControl_pwr.sch, uControl

Parts:
C18, C20, C32, C34: 100nF; c_0805
C19, C33: 22uF X7R; c_1210
C21, C35: 3.3nF; c_0805
C22, C26, C36, C37: 100uF; C_ELCO_SMD
C30, C38: 10uF X7R; c_1206
D4: S1D-13-F; diode-DO214AC
D5: 5V0; led_0805
D6: 3V3; led_0805
D7: BLINK; led_0805
D8: 12V; led_0805
G1, G2: Logo_Wyolum; Logo-WL3
G3, G4: Logo_OH; OSHW_6mm
J1: 5V_EXT; Header_2
J2: 3V3_EXT; Header_2
L1, L2: 2u2H,3.0A; Inductor_SMD3; Mfr_PN XFL4020-222MEB, Coilcraft
P13: PWR_IN; Header_2
P24: PWR_IN; JACK_ALIM
PCB1: PCB
R7, R14: 100k; r_0805
R8: 330E; r_0805
R9: 120E; r_0805
R10, R13: 1k; r_0805
U3: TPS62133; TPS62132
U4: TPS62132

Connections:
+3.3V: C32.2, C33.1, J2.1, L2.2, R9.1, R14.2, U4.14 (VOS); also elsewhere on the board
/BBB/5V0: C18.2, C19.1, J1.1, L1.2, R7.2, R8.1, U3.14 (VOS); also elsewhere on the board
/BBB/SCK: R10.1; also elsewhere on the board
/Interface/12V: C20.2, C22.1, C26.1, C30.1, C34.2, C36.1, C37.1, C38.1, D4.2 (K), R13.1, U3.10 (AVIN), U3.11 (PVIN), U3.12 (PVIN), U3.13 (EN), U4.10 (AVIN), U4.11 (PVIN), U4.12 (PVIN), U4.13 (EN); also elsewhere on the board
/pwr/PWR_IN: D4.1 (A), P13.1, P24.1 (+)
GND: C18.1, C19.2, C20.1, C21.1, C22.2, C26.2, C30.2, C32.1, C33.2, C34.1, C35.1, C36.2, C37.2, C38.2, D5.2 (K), D6.2 (K), D7.2 (K), D8.2 (K), J1.2 (PM), J2.2 (PM), P13.2 (PM), P24.2 (-), P24.3 (S), U3.5 (FB), U3.6 (AGND), U3.7 (FSW), U3.8 (DEF), U3.15 (PGND), U3.16 (PGND), U4.5 (FB), U4.6 (AGND), U4.7 (FSW), U4.8 (DEF), U4.15 (PGND), U4.16 (PGND); also elsewhere on the board
unnamed: C21.2, U3.9 (SS/TR)
unnamed: L1.1, U3.1 (SW), U3.2 (SW), U3.3 (SW)
unnamed: R7.1, U3.4 (PG)
unnamed: D7.1 (A), R10.2
unnamed: D8.1 (A), R13.2
unnamed: D6.1 (A), R9.2
unnamed: D5.1 (A), R8.2
unnamed: C35.2, U4.9 (SS/TR)
unnamed: L2.1, U4.1 (SW), U4.2 (SW), U4.3 (SW)
unnamed: R14.1, U4.4 (PG)

Notes on the sheet:
5V0 Regulator for uControl
INDICATORS
BLINK LED - D13
BARREL POWER SOCKET
3V3 Regulator for uControl

Schematic: uControl_rtc.sch, uControl

Parts:
B1, B2, B3: I_O
BT1: BATT_HOLDER; CR2032
BT2: BATT_COIN
C23: 100nF; c_0805
R11: 10k; r_0805
U5: DS3231N; DS3231

Connections:
/BBB/5V0: R11.1, U5.2 (Vcc); also elsewhere on the board
/BBB/SCL: U5.16 (SCL); also elsewhere on the board
/BBB/SDA: U5.15 (SDA); also elsewhere on the board
/rtc/32k: B3.1, U5.1 (32KHz)
/rtc/BAT: BT1.+, C23.1, U5.14 (Vbat)
/rtc/RST: B2.1, U5.4 (!(Reset))
/rtc/SQR: B1.1, R11.2, U5.3 (!(INT)/SQR)
GND: BT1.-, C23.2, U5.5 (NC), U5.6 (NC), U5.7 (NC), U5.8 (NC), U5.9 (NC), U5.10 (NC), U5.11 (NC), U5.12 (NC), U5.13 (GND); also elsewhere on the board

Schematic: BBB.sch

Parts:
B5: 5V_ATMega; I_O
B6: 3V3_BBB; I_O
C39, C40, C41: 100nF; c_0805
J3: addr; Header_2x2
P19: U6_OE; ShortLink2
P20: 5V_LINK; ShortLink2
P21, P22: CONN_23X2; PIN_ARRAY_23X2
Q5: 2N7002KW; SOT323
R12: 4k7; r_0805
R15, R26, R27: 10k; r_0805
R16, R17, R18, R23: 4k75; r_0805
R19, R20: 1k5; r_0805
R24, R25: 220; r_0805
SW4: PWR_BBB; SW_PB_V_H
SW5: GPIO1_6; SW_PB_V_H
SW6: GPIO1_29; SW_PB_V_H
U8: TSX0108; TXS0108EPWR
U9: CAT24C256; SO8E
U10: BEAGLEBONE

Connections:
/BBB/3V3_BBB: B6.1, Q5.S, R27.2
/BBB/5V0: C39.2, P20.1, R26.1, U8.19 (VCCB); also elsewhere on the board
/BBB/5V_ATMega: B5.1, Q5.D, R26.2
/BBB/A0: J3.3, R16.2, U9.1 (A0)
/BBB/A1: J3.1, R17.2, U9.2 (A1)
/BBB/A2: R18.2, U9.3 (A2)
/BBB/AIN0: P21.39, U10.C39 (AIN0)
/BBB/AIN1: P21.40, U10.C40 (AIN1)
/BBB/AIN2: P21.37, U10.C37 (AIN2)
/BBB/AIN3: P21.38, U10.C38 (AIN3)
/BBB/AIN4: P21.33, U10.C33 (AIN4)
/BBB/AIN5: P21.36, U10.C36 (AIN5)
/BBB/AIN6: P21.35, U10.C35 (AIN6)
/BBB/BBB_OE: P19.2, R15.1, U8.10 (OE)
/BBB/CLKOUT2: P21.41, U10.C41 (CLKOUT2)
/BBB/DGND_8: P22.1, P22.2, U10.B1 (DGND), U10.B2 (DGND)
/BBB/DGND_9_2: P21.43, P21.44, P21.45, P21.46, U10.C43 (DGND), U10.C44 (DGND), U10.C45 (DGND), U10.C46 (DGND)
/BBB/EHRPWM1A: P21.14, U10.C14 (EHRPWM1A)
/BBB/EHRPWM1B: P21.16, U10.C16 (EHRPWM1B)
/BBB/EHRPWM2A: P22.19, U10.B19 (EHRPWM2A)
/BBB/EHRPWM2B: P22.13, U10.B13 (EHRPWM2B)
/BBB/GNDA_ADC: P21.34, U10.C34 (GNDA_ADC)
/BBB/GPIO0_7: P21.42, U10.C42 (GPIO0_7)
/BBB/GPIO0_26: P22.14, U10.B14 (GPIO0_26)
/BBB/GPIO0_27: P22.17, U10.B17 (GPIO0_27)
/BBB/GPIO1_0: P22.25, U10.B25 (GPIO1_0)
/BBB/GPIO1_1: P22.24, U10.B24 (GPIO1_1)
/BBB/GPIO1_2: P22.5, U10.B5 (GPIO1_2)
/BBB/GPIO1_3: P22.6, U10.B6 (GPIO1_3)
/BBB/GPIO1_4: P22.23, U10.B23 (GPIO1_4)
/BBB/GPIO1_5: P22.22, U10.B22 (GPIO1_5)
/BBB/GPIO1_6: P22.3, U10.B3 (GPIO1_6)
/BBB/GPIO1_7: P22.4, U10.B4 (GPIO1_7)
/BBB/GPIO1_12: P22.12, U10.B12 (GPIO1_12)
/BBB/GPIO1_13: P22.11, U10.B11 (GPIO1_13)
/BBB/GPIO1_14: P22.16, U10.B16 (GPIO1_14)
/BBB/GPIO1_15: P22.15, U10.B15 (GPIO1_15)
/BBB/GPIO1_16: P21.15, U10.C15 (GPIO1_16)
/BBB/GPIO1_17: P21.23, U10.C23 (GPIO1_17)
/BBB/GPIO1_28: P21.12, U10.C12 (GPIO1_28)
/BBB/GPIO1_29: P22.26, R23.2, R25.1, U10.B26 (GPIO1_29)
/BBB/GPIO1_30: P22.21, U10.B21 (GPIO1_30)
/BBB/GPIO1_31: P22.20, U10.B20 (GPIO1_31)
/BBB/GPIO2_1: P22.18, U10.B18 (GPIO2_1)
/BBB/GPIO2_6: P22.45, U10.B45 (GPIO2_6)
/BBB/GPIO2_7: P22.46, U10.B46 (GPIO2_7)
/BBB/GPIO2_8: P22.43, U10.B43 (GPIO2_8)
/BBB/GPIO2_9: P22.44, U10.B44 (GPIO2_9)
/BBB/GPIO2_10: P22.41, U10.B41 (GPIO2_10)
/BBB/GPIO2_11: P22.42, U10.B42 (GPIO2_11)
/BBB/GPIO2_13: P22.40, U10.B40 (GPIO2_13)
/BBB/GPIO2_22: P22.27, U10.B27 (GPIO2_22)
/BBB/GPIO2_23: P22.29, U10.B29 (GPIO2_23)
/BBB/GPIO2_24: P22.28, U10.B28 (GPIO2_24)
/BBB/GPIO2_25: P22.30, U10.B30 (GPIO2_25)
/BBB/GPIO3_19: P21.27, U10.C27 (GPIO3_19)
/BBB/GPIO3_21: P21.25, U10.C25 (GPIO3_21)
/BBB/GPIO_12: P22.39, U10.B39 (GPIO2_12)
/BBB/I2C1_SCL: P21.17, U8.3 (A2), U10.C17 (I2C1_SCL); also elsewhere on the board
/BBB/I2C1_SDA: P21.18, U8.1 (A1), U10.C18 (I2C1_SDA); also elsewhere on the board
/BBB/I2C2_SCL: P21.19, R19.2, U9.6 (SCL), U10.C19 (I2C2_SCL)
/BBB/I2C2_SDA: P21.20, R20.2, U9.5 (SDA), U10.C20 (I2C2_SDA)
/BBB/MISO: U8.13 (B7); also elsewhere on the board
/BBB/PWR_BUT: P21.9, SW4.2, U10.C9 (PWR_BUT)
/BBB/RESET: U8.15 (B5); also elsewhere on the board
/BBB/RXD: U8.17 (B3); also elsewhere on the board
/BBB/SCK: U8.12 (B8); also elsewhere on the board
/BBB/SCL: U8.18 (B2); also elsewhere on the board
/BBB/SDA: U8.20 (B1); also elsewhere on the board
/BBB/SPI1_CS0: P21.28, U10.C28 (SPI1_CS0)
/BBB/SPI1_D0: P21.29, U8.8 (A7), U10.C29 (SPI1_D0)
/BBB/SPI1_D1: P21.30, U8.7 (A6), U10.C30 (SPI1_D1)
/BBB/SPI1_SCLK: P21.31, U8.9 (A8), U10.C31 (SPI1_SCLK)
/BBB/SYS_5V: P21.7, P21.8, U10.C7 (SYS_5V), U10.C8 (SYS_5V)
/BBB/SYS_RESETn: P21.10, U10.C10 (SYS_RESETn)
/BBB/TIMER4: P22.7, U10.B7 (TIMER4)
/BBB/TIMER5: P22.9, R12.2, R24.1, U10.B9 (TIMER5)
/BBB/TIMER6: P22.10, U8.6 (A5), U10.B10 (TIMER6)
/BBB/TIMER7: P22.8, U10.B8 (TIMER7)
/BBB/TXD: U8.16 (B4); also elsewhere on the board
/BBB/UART1_RXD: P21.26, U8.5 (A4), U10.C26 (UART1_RXD)
/BBB/UART1_TXD: P21.24, U8.4 (A3), U10.C24 (UART1_TXD)
/BBB/UART2_RXD: P21.22, U10.C22 (UART2_RXD)
/BBB/UART2_TXD: P21.21, U10.C21 (UART2_TXD)
/BBB/UART3_CTSN: P22.36, U10.B36 (UART3_CTSN)
/BBB/UART3_RTSN: P22.34, U10.B34 (UART3_RTSN)
/BBB/UART4_CTSN: P22.35, U10.B35 (UART4_CTSN)
/BBB/UART4_RTSN: P22.33, U10.B33 (UART4_RTSN)
/BBB/UART4_RXD: P21.11, U10.C11 (UART4_RXD)
/BBB/UART4_TXD: P21.13, U10.C13 (UART4_TXD)
/BBB/UART5_CTSN: P22.31, U10.B31 (UART5_CTSN)
/BBB/UART5_RTSN: P22.32, U10.B32 (UART5_RTSN)
/BBB/UART5_RXD: P22.38, U10.B38 (UART5_RXD)
/BBB/UART5_TXD: P22.37, U10.B37 (UART5_TXD)
/BBB/VDD_3V3EXP: C40.2, C41.1, P19.1, P21.3, P21.4, Q5.G, R12.1, R16.1, R17.1, R18.1, R19.1, R20.1, R23.1, R27.1, U8.2 (VCCA), U9.8 (VCC), U10.C3 (VDD_3V3EXP), U10.C4 (VDD_3V3EXP)
/BBB/VDD_5V: P20.2, P21.5, P21.6, U10.C5 (VDD_5V), U10.C6 (VDD_5V)
/BBB/VDD_ADC: P21.32, U10.C32 (VDD_ADC)
/BBB/~MOSI: U8.14 (B6); also elsewhere on the board
GND: C39.1, C40.1, C41.2, J3.2, J3.4, P19.3, P21.1, P21.2, R15.2, SW4.1, SW5.1, SW6.1, U8.11 (GND), U9.4 (GND), U10.C1 (DGND), U10.C2 (DGND); also elsewhere on the board
unnamed: R24.2, SW5.2
unnamed: R25.2, SW6.2

Notes on the sheet:
allows linking BBB 5V to uC_v3 5V
Enable/Disable U6 for comm betn BBB & uC_v3
LEVEL TRANSLATOR ATMega (5V) <> BBB (3V3)
Discrete LEVEL TRANSLATOR ATMega (5V) <> BBB (3V3)
(can use for SPI Select betn ATMega <> BBB)
BBB Buttons General purpose
BBB I2C for Accelerometer

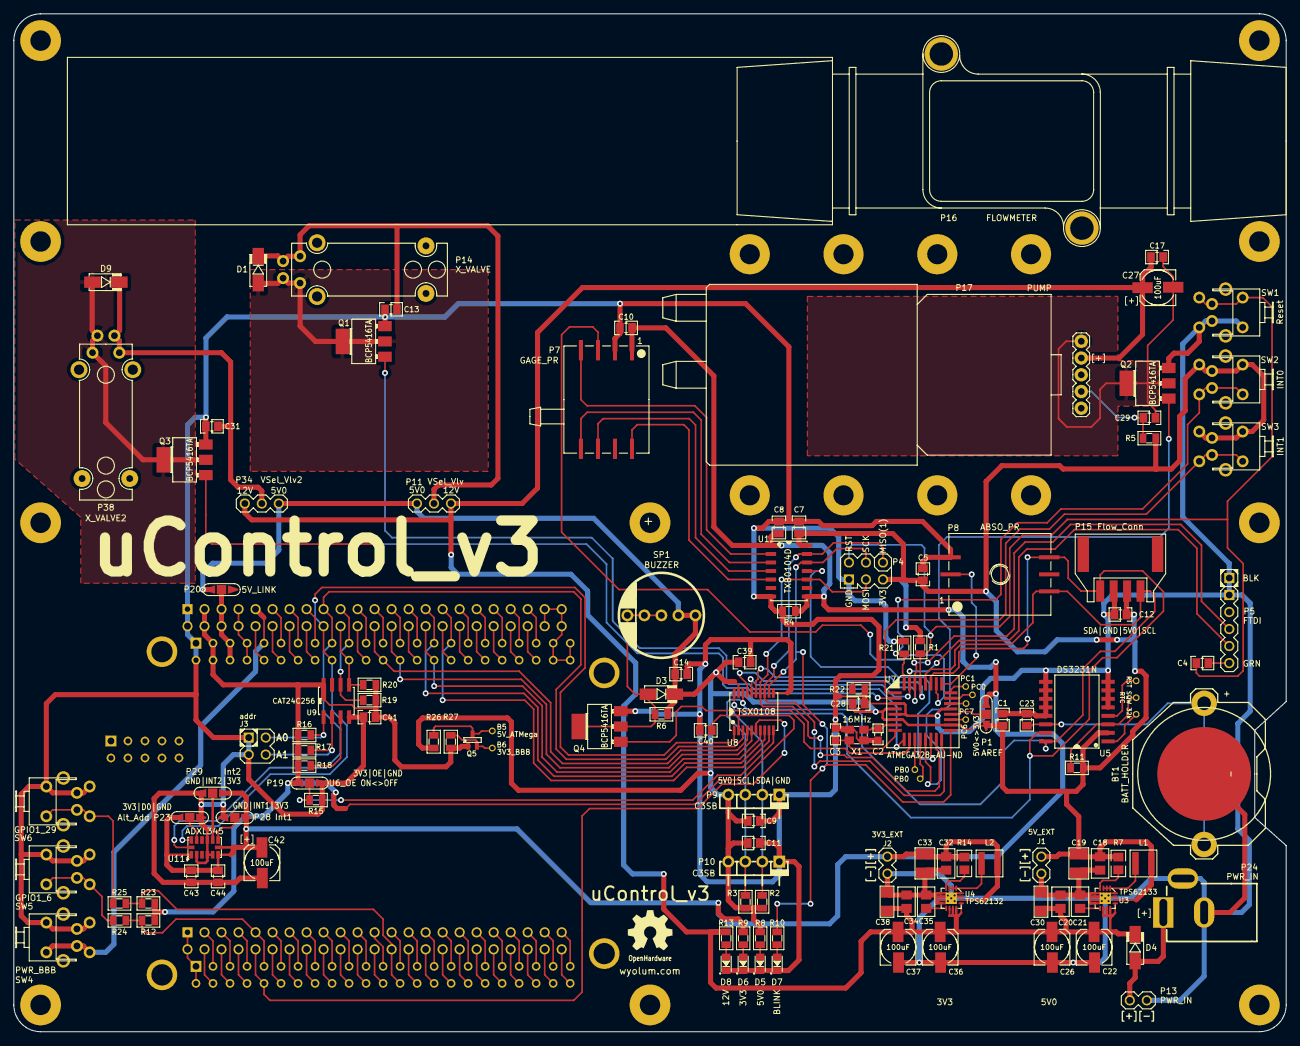
[picture p12: board uControl_v3.kicad_pcb from above]

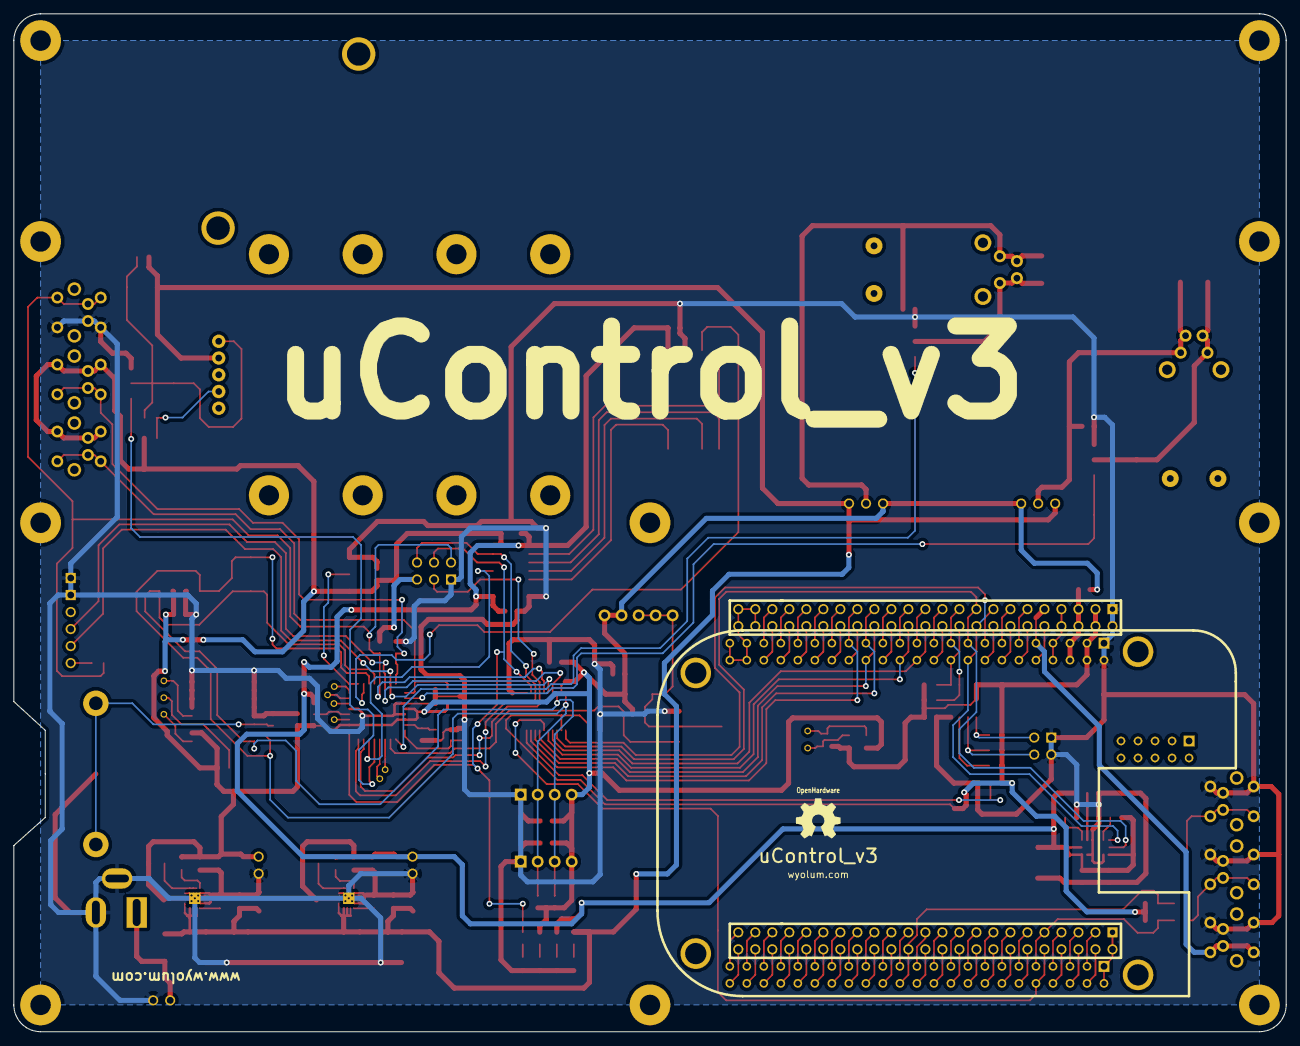
[picture p13: board uControl_v3.kicad_pcb from below]

Board: 2 copper layers, 190.0 x 152.0 mm, 149 parts (4 on the bottom side), 151 nets.
