wyolum/uControl_v3/KiCAD/uControl_Libs/FlyingBone-master/kicad/P8.sch

## KiCad design KiCAD/uControl_Libs/FlyingBone-master/kicad/P8.sch (2015-07-04)

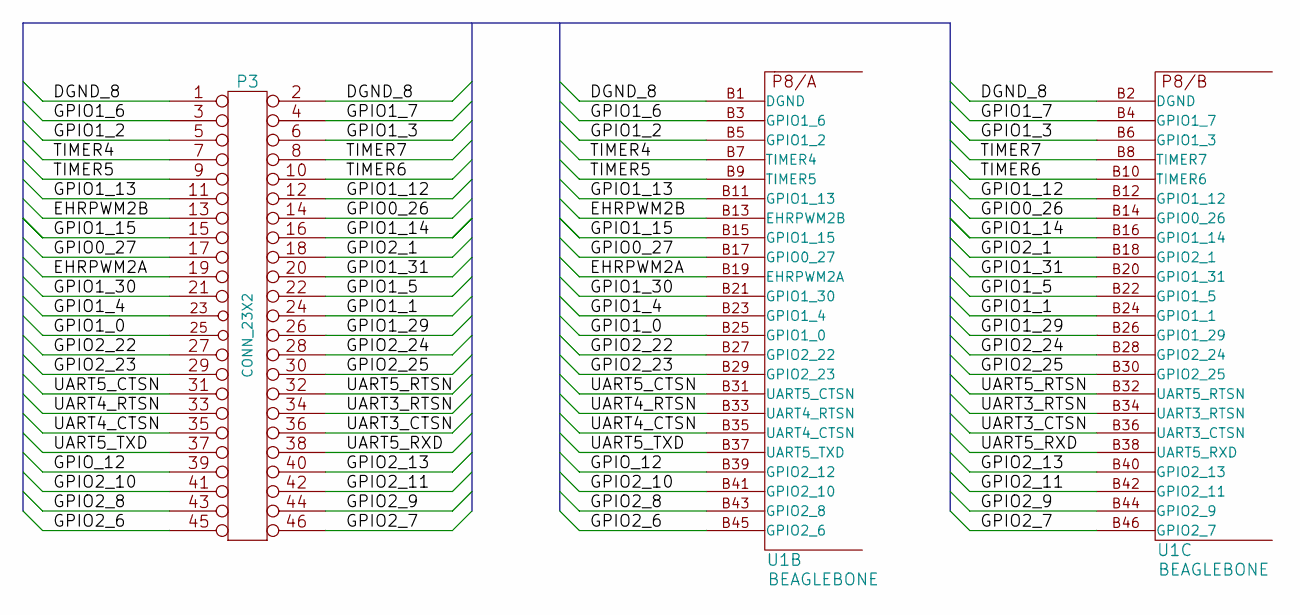
[picture p14: schematic P8.sch]

Parts:
P3: CONN_23X2
U1: BEAGLEBONE

Connections:
DGND_8: P3.1, P3.2, U1.B1 (DGND), U1.B2 (DGND)
EHRPWM2A: P3.19, U1.B19 (EHRPWM2A)
EHRPWM2B: P3.13, U1.B13 (EHRPWM2B)
GPIO0_26: P3.14, U1.B14 (GPIO0_26)
GPIO0_27: P3.17, U1.B17 (GPIO0_27)
GPIO1_0: P3.25, U1.B25 (GPIO1_0)
GPIO1_1: P3.24, U1.B24 (GPIO1_1)
GPIO1_2: P3.5, U1.B5 (GPIO1_2)
GPIO1_3: P3.6, U1.B6 (GPIO1_3)
GPIO1_4: P3.23, U1.B23 (GPIO1_4)
GPIO1_5: P3.22, U1.B22 (GPIO1_5)
GPIO1_6: P3.3, U1.B3 (GPIO1_6)
GPIO1_7: P3.4, U1.B4 (GPIO1_7)
GPIO1_12: P3.12, U1.B12 (GPIO1_12)
GPIO1_13: P3.11, U1.B11 (GPIO1_13)
GPIO1_14: P3.16, U1.B16 (GPIO1_14)
GPIO1_15: P3.15, U1.B15 (GPIO1_15)
GPIO1_29: P3.26, U1.B26 (GPIO1_29)
GPIO1_30: P3.21, U1.B21 (GPIO1_30)
GPIO1_31: P3.20, U1.B20 (GPIO1_31)
GPIO2_1: P3.18, U1.B18 (GPIO2_1)
GPIO2_6: P3.45, U1.B45 (GPIO2_6)
GPIO2_7: P3.46, U1.B46 (GPIO2_7)
GPIO2_8: P3.43, U1.B43 (GPIO2_8)
GPIO2_9: P3.44, U1.B44 (GPIO2_9)
GPIO2_10: P3.41, U1.B41 (GPIO2_10)
GPIO2_11: P3.42, U1.B42 (GPIO2_11)
GPIO2_13: P3.40, U1.B40 (GPIO2_13)
GPIO2_22: P3.27, U1.B27 (GPIO2_22)
GPIO2_23: P3.29, U1.B29 (GPIO2_23)
GPIO2_24: P3.28, U1.B28 (GPIO2_24)
GPIO2_25: P3.30, U1.B30 (GPIO2_25)
GPIO_12: P3.39, U1.B39 (GPIO2_12)
TIMER4: P3.7, U1.B7 (TIMER4)
TIMER5: P3.9, U1.B9 (TIMER5)
TIMER6: P3.10, U1.B10 (TIMER6)
TIMER7: P3.8, U1.B8 (TIMER7)
UART3_CTSN: P3.36, U1.B36 (UART3_CTSN)
UART3_RTSN: P3.34, U1.B34 (UART3_RTSN)
UART4_CTSN: P3.35, U1.B35 (UART4_CTSN)
UART4_RTSN: P3.33, U1.B33 (UART4_RTSN)
UART5_CTSN: P3.31, U1.B31 (UART5_CTSN)
UART5_RTSN: P3.32, U1.B32 (UART5_RTSN)
UART5_RXD: P3.38, U1.B38 (UART5_RXD)
UART5_TXD: P3.37, U1.B37 (UART5_TXD)
