wyolum/uControl_v3/KiCAD/uControl_Libs/FlyingBone-master/kicad/P9.sch

## KiCad design KiCAD/uControl_Libs/FlyingBone-master/kicad/P9.sch (2015-07-04)

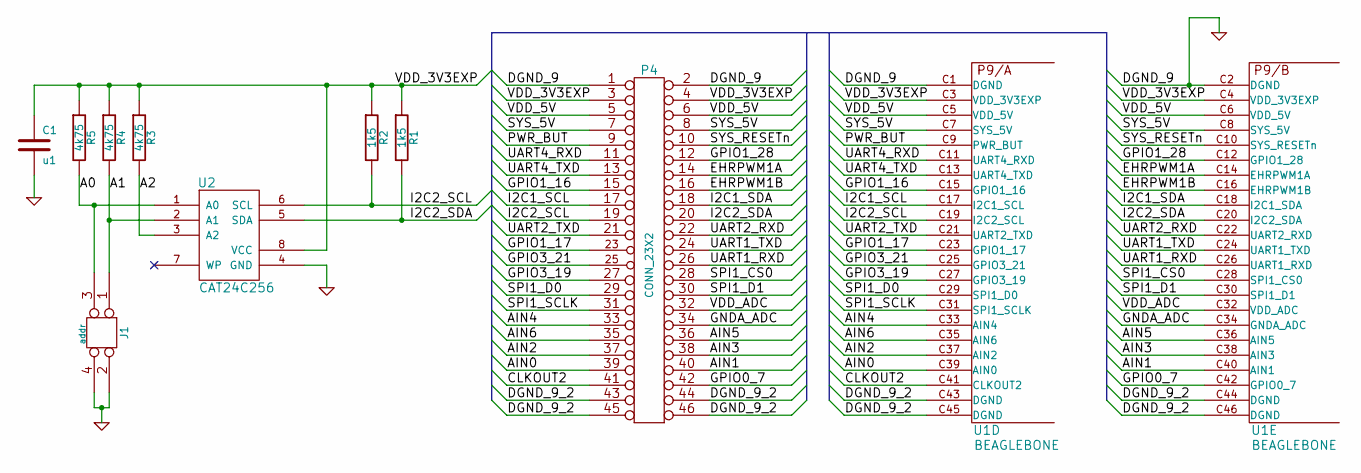
[picture p15: schematic P9.sch]

Parts:
C1: u1
J1: addr
P4: CONN_23X2
R1, R2: 1k5
R3, R4, R5: 4k75
U1: BEAGLEBONE
U2: CAT24C256

Connections:
A0: J1.3, R5.2, U2.1 (A0)
A1: J1.1, R4.2, U2.2 (A1)
A2: R3.2, U2.3 (A2)
AIN0: P4.39, U1.C39 (AIN0)
AIN1: P4.40, U1.C40 (AIN1)
AIN2: P4.37, U1.C37 (AIN2)
AIN3: P4.38, U1.C38 (AIN3)
AIN4: P4.33, U1.C33 (AIN4)
AIN5: P4.36, U1.C36 (AIN5)
AIN6: P4.35, U1.C35 (AIN6)
CLKOUT2: P4.41, U1.C41 (CLKOUT2)
DGND_9_2: P4.43, P4.44, P4.45, P4.46, U1.C43 (DGND), U1.C44 (DGND), U1.C45 (DGND), U1.C46 (DGND)
EHRPWM1A: P4.14, U1.C14 (EHRPWM1A)
EHRPWM1B: P4.16, U1.C16 (EHRPWM1B)
GND: C1.2, J1.2, J1.4, P4.1, P4.2, U1.C1 (DGND), U1.C2 (DGND), U2.4 (GND)
GNDA_ADC: P4.34, U1.C34 (GNDA_ADC)
GPIO0_7: P4.42, U1.C42 (GPIO0_7)
GPIO1_16: P4.15, U1.C15 (GPIO1_16)
GPIO1_17: P4.23, U1.C23 (GPIO1_17)
GPIO1_28: P4.12, U1.C12 (GPIO1_28)
GPIO3_19: P4.27, U1.C27 (GPIO3_19)
GPIO3_21: P4.25, U1.C25 (GPIO3_21)
I2C1_SCL: P4.17, U1.C17 (I2C1_SCL)
I2C1_SDA: P4.18, U1.C18 (I2C1_SDA)
I2C2_SCL: P4.19, R2.2, U1.C19 (I2C2_SCL), U2.6 (SCL)
I2C2_SDA: P4.20, R1.2, U1.C20 (I2C2_SDA), U2.5 (SDA)
PWR_BUT: P4.9, U1.C9 (PWR_BUT)
SPI1_CS0: P4.28, U1.C28 (SPI1_CS0)
SPI1_D0: P4.29, U1.C29 (SPI1_D0)
SPI1_D1: P4.30, U1.C30 (SPI1_D1)
SPI1_SCLK: P4.31, U1.C31 (SPI1_SCLK)
SYS_5V: P4.7, P4.8, U1.C7 (SYS_5V), U1.C8 (SYS_5V)
SYS_RESETn: P4.10, U1.C10 (SYS_RESETn)
UART1_RXD: P4.26, U1.C26 (UART1_RXD)
UART1_TXD: P4.24, U1.C24 (UART1_TXD)
UART2_RXD: P4.22, U1.C22 (UART2_RXD)
UART2_TXD: P4.21, U1.C21 (UART2_TXD)
UART4_RXD: P4.11, U1.C11 (UART4_RXD)
UART4_TXD: P4.13, U1.C13 (UART4_TXD)
VDD_3V3EXP: C1.1, P4.3, P4.4, R1.1, R2.1, R3.1, R4.1, R5.1, U1.C3 (VDD_3V3EXP), U1.C4 (VDD_3V3EXP), U2.8 (VCC)
VDD_5V: P4.5, P4.6, U1.C5 (VDD_5V), U1.C6 (VDD_5V)
VDD_ADC: P4.32, U1.C32 (VDD_ADC)
