wyolum/uControl_v3/KiCAD/uControl_Libs/FlyingBone-master/kicad/batt_backight.sch

## KiCad design KiCAD/uControl_Libs/FlyingBone-master/kicad/batt_backight.sch (2015-07-04)

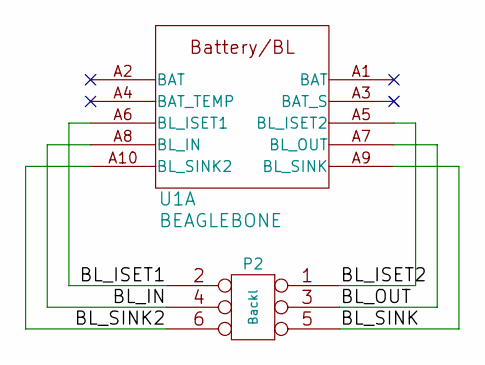
[picture p16: schematic batt_backight.sch]

Parts:
P2: Backl
U1: BEAGLEBONE

Connections:
BL_IN: P2.4, U1.A8 (BL_IN)
BL_ISET1: P2.2, U1.A6 (BL_ISET1)
BL_ISET2: P2.1, U1.A5 (BL_ISET2)
BL_OUT: P2.3, U1.A7 (BL_OUT)
BL_SINK: P2.5, U1.A9 (BL_SINK)
BL_SINK2: P2.6, U1.A10 (BL_SINK2)
