wyolum/uControl_v3/KiCAD/uControl_Libs/FlyingBone-master/kicad/c_holes.sch

## KiCad design KiCAD/uControl_Libs/FlyingBone-master/kicad/c_holes.sch (2015-07-04)

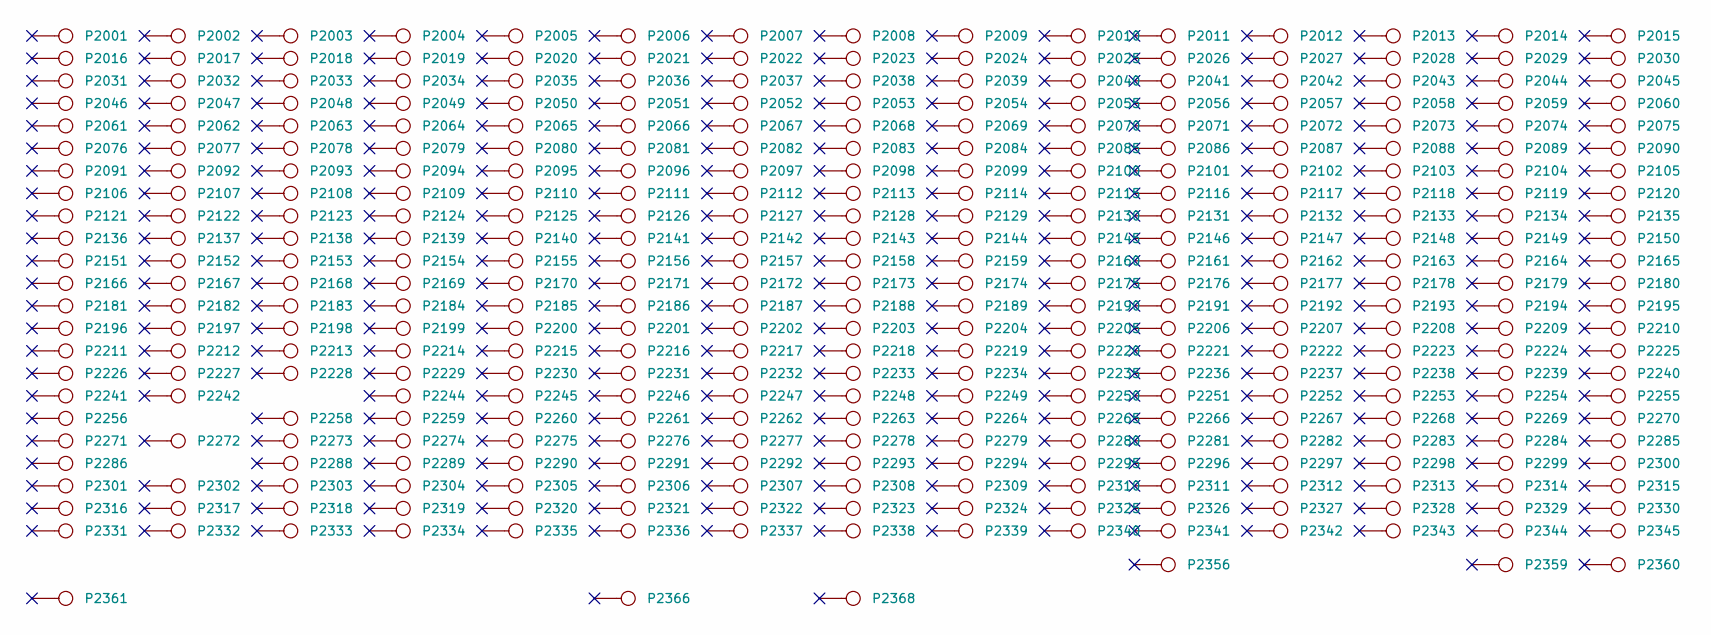
[picture p17: schematic c_holes.sch]

Parts:
P2001, P2002, P2003, P2004, P2005, P2006, P2007, P2008, P2009, P2010, P2011, P2012, P2013, P2014, P2015, P2016, P2017, P2018, P2019, P2020, P2021, P2022, P2023, P2024, P2025, P2026, P2027, P2028, P2029, P2030, P2031, P2032, P2033, P2034, P2035, P2036, P2037, P2038, P2039, P2040, P2041, P2042, P2043, P2044, P2045, P2046, P2047, P2048, P2049, P2050, P2051, P2052, P2053, P2054, P2055, P2056, P2057, P2058, P2059, P2060, P2061, P2062, P2063, P2064, P2065, P2066, P2067, P2068, P2069, P2070, P2071, P2072, P2073, P2074, P2075, P2076, P2077, P2078, P2079, P2080, P2081, P2082, P2083, P2084, P2085, P2086, P2087, P2088, P2089, P2090, P2091, P2092, P2093, P2094, P2095, P2096, P2097, P2098, P2099, P2100, P2101, P2102, P2103, P2104, P2105, P2106, P2107, P2108, P2109, P2110, P2111, P2112, P2113, P2114, P2115, P2116, P2117, P2118, P2119, P2120, P2121, P2122, P2123, P2124, P2125, P2126, P2127, P2128, P2129, P2130, P2131, P2132, P2133, P2134, P2135, P2136, P2137, P2138, P2139, P2140, P2141, P2142, P2143, P2144, P2145, P2146, P2147, P2148, P2149, P2150, P2151, P2152, P2153, P2154, P2155, P2156, P2157, P2158, P2159, P2160, P2161, P2162, P2163, P2164, P2165, P2166, P2167, P2168, P2169, P2170, P2171, P2172, P2173, P2174, P2175, P2176, P2177, P2178, P2179, P2180, P2181, P2182, P2183, P2184, P2185, P2186, P2187, P2188, P2189, P2190, P2191, P2192, P2193, P2194, P2195, P2196, P2197, P2198, P2199, P2200, P2201, P2202, P2203, P2204, P2205, P2206, P2207, P2208, P2209, P2210, P2211, P2212, P2213, P2214, P2215, P2216, P2217, P2218, P2219, P2220, P2221, P2222, P2223, P2224, P2225, P2226, P2227, P2228, P2229, P2230, P2231, P2232, P2233, P2234, P2235, P2236, P2237, P2238, P2239, P2240, P2241, P2242, P2244, P2245, P2246, P2247, P2248, P2249, P2250, P2251, P2252, P2253, P2254, P2255, P2256, P2258, P2259, P2260, P2261, P2262, P2263, P2264, P2265, P2266, P2267, P2268, P2269, P2270, P2271, P2272, P2273, P2274, P2275, P2276, P2277, P2278, P2279, P2280, P2281, P2282, P2283, P2284, P2285, P2286, P2288, P2289, P2290, P2291, P2292, P2293, P2294, P2295, P2296, P2297, P2298, P2299, P2300, P2301, P2302, P2303, P2304, P2305, P2306, P2307, P2308, P2309, P2310, P2311, P2312, P2313, P2314, P2315, P2316, P2317, P2318, P2319, P2320, P2321, P2322, P2323, P2324, P2325, P2326, P2327, P2328, P2329, P2330, P2331, P2332, P2333, P2334, P2335, P2336, P2337, P2338, P2339, P2340, P2341, P2342, P2343, P2344, P2345, P2356, P2359, P2360, P2361, P2366, P2368: CONN_1
