wyolum/uControl_v3/(commit log)

2015-07-04 initial commit from code.google.com
    [BBB.scad, BBB.sch, BoM_uControl_v3.ods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]
2015-08-18 added arduino code and scritps
2015-08-24 invitro test program for measuring air and water pressure
2015-08-26 create invitro test scripts, flow is replaced with liquid pressure.
    [constants.py, drive.py, peakdetect.py, plot_uc.py, record.py, uControl.py, util.py]
2015-09-16 added plunger_holder files and bartendro screen holder
    [plunger_holder.scad, plunger_holder.stl]
2015-09-16 updated plunger spring holder
    [plunger_holder.scad]
2015-10-03 dead computer recovery
    [spring_catch.scad]
