wyolum/uControl_v3/(notices)

Notices in the files:
parts and their libraries:
CC-BY-SA
